ohameiri/maya/hardware/lr2021-esp32s3/docs/enclosure/01_closed_front_left.png

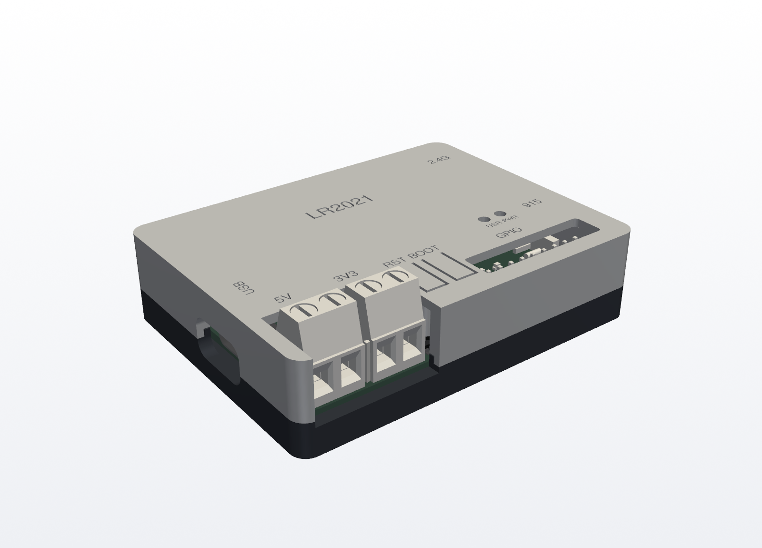
hardware/lr2021-esp32s3/docs/enclosure/01_closed_front_left.png
