ohameiri/maya/hardware/lr2021-esp32s3/docs/enclosure/03_exploded.png

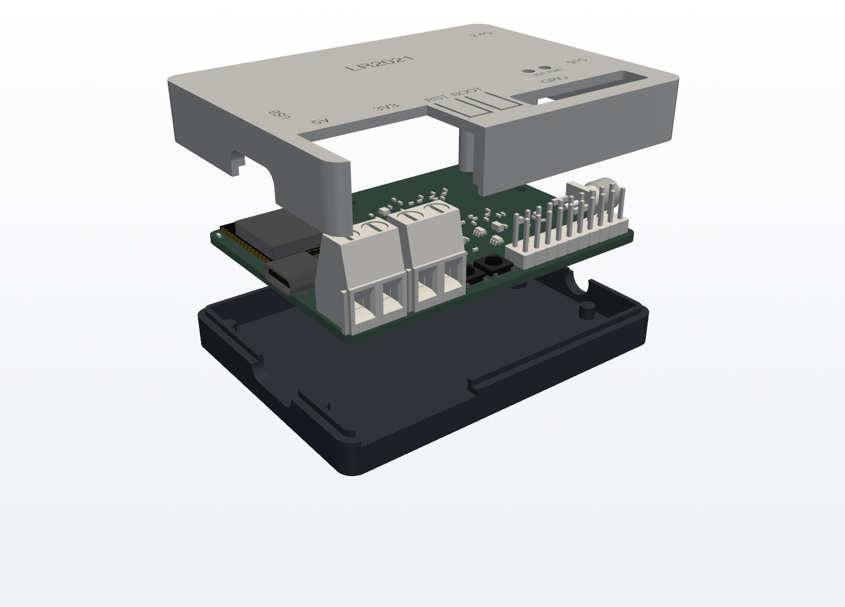
hardware/lr2021-esp32s3/docs/enclosure/03_exploded.png
