ohameiri/maya/hardware/lr2021-esp32s3/docs/enclosure/04_base_with_board.png

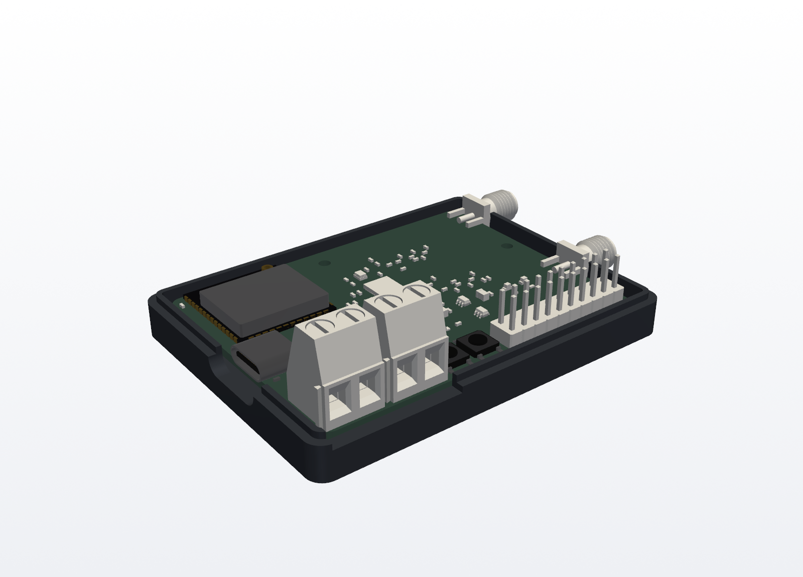
hardware/lr2021-esp32s3/docs/enclosure/04_base_with_board.png
