ohameiri/maya/hardware/lr2021-esp32s3/docs/enclosure/06_lid_top.png

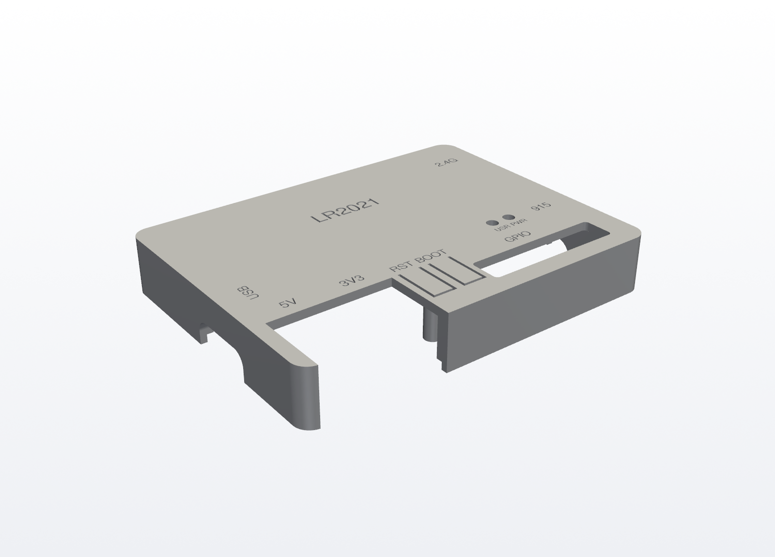
hardware/lr2021-esp32s3/docs/enclosure/06_lid_top.png
