ohameiri/maya/hardware/lr2021-esp32s3/docs/enclosure/07_lid_underside.png

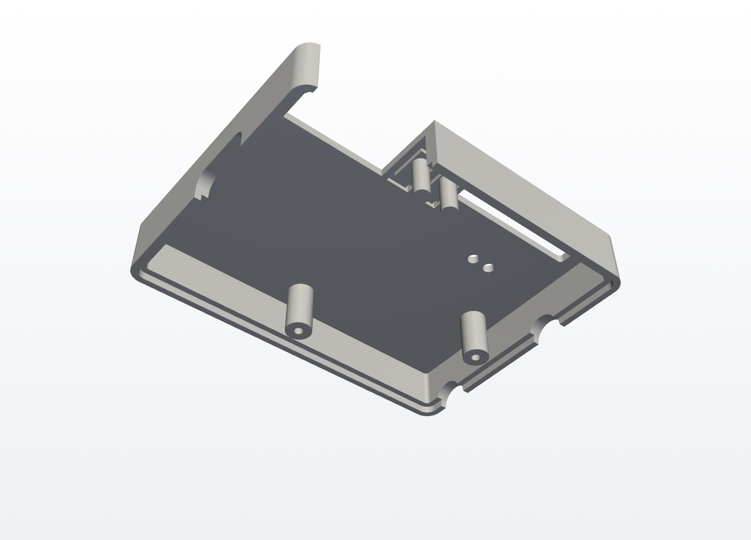
hardware/lr2021-esp32s3/docs/enclosure/07_lid_underside.png
