ohameiri/maya/hardware/lr2021-esp32s3/docs/enclosure/09_exploded_no_board.png

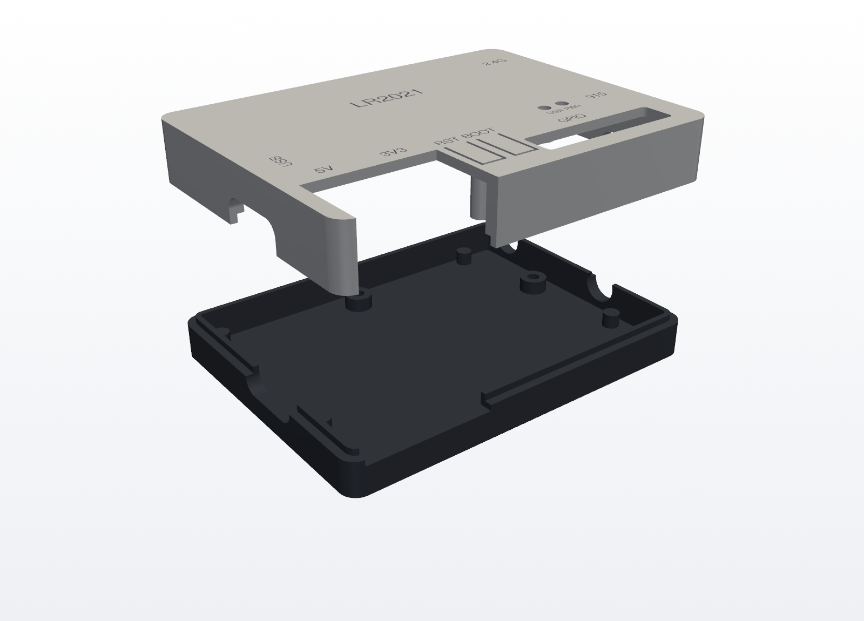
hardware/lr2021-esp32s3/docs/enclosure/09_exploded_no_board.png
