ohameiri/maya/hardware/lr2021-esp32s3/docs/enclosure/10_top_view.png

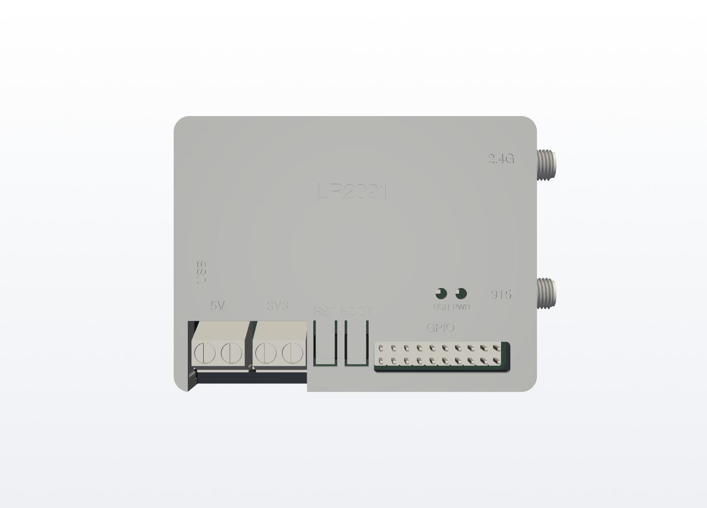
hardware/lr2021-esp32s3/docs/enclosure/10_top_view.png
