ohameiri/maya/hardware/lr2021-esp32s3/docs/enclosure/11_usb_side.png

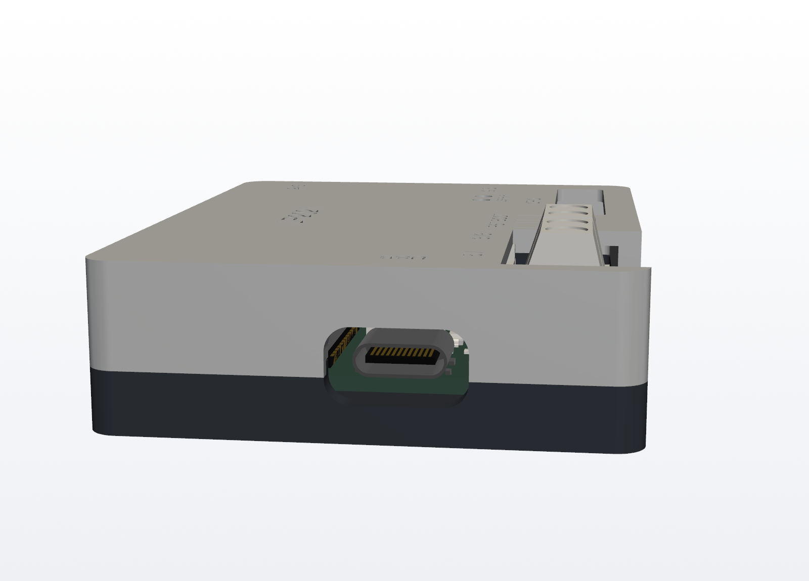
hardware/lr2021-esp32s3/docs/enclosure/11_usb_side.png
