ohameiri/maya/hardware/lr2021-esp32s3/docs/enclosure/12_sma_side.png

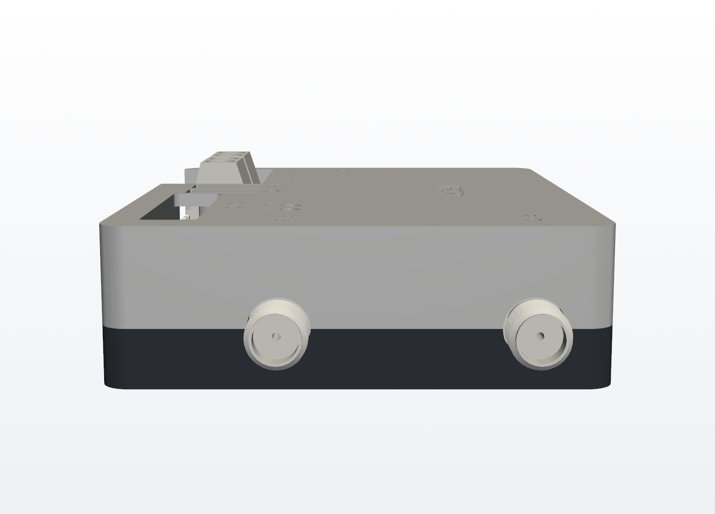
hardware/lr2021-esp32s3/docs/enclosure/12_sma_side.png
