ohameiri/maya/hardware/lr2021-esp32s3/docs/gallery/3d_esp32_zoom_angle.png

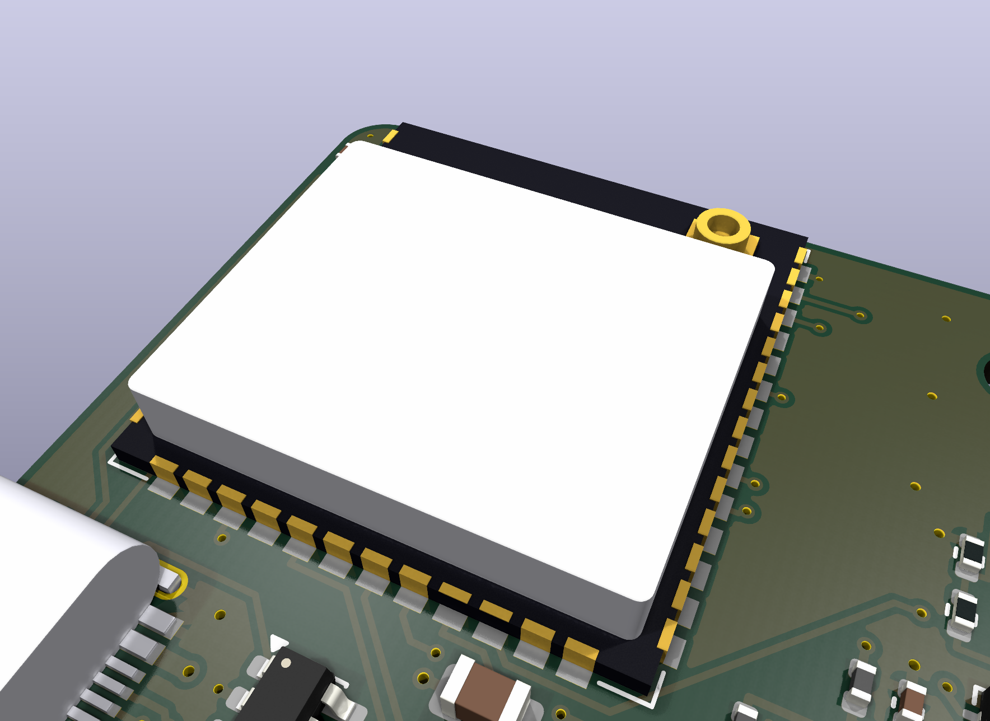
hardware/lr2021-esp32s3/docs/gallery/3d_esp32_zoom_angle.png
