ohameiri/maya/hardware/lr2021-esp32s3/docs/gallery/3d_iso_front_left.png

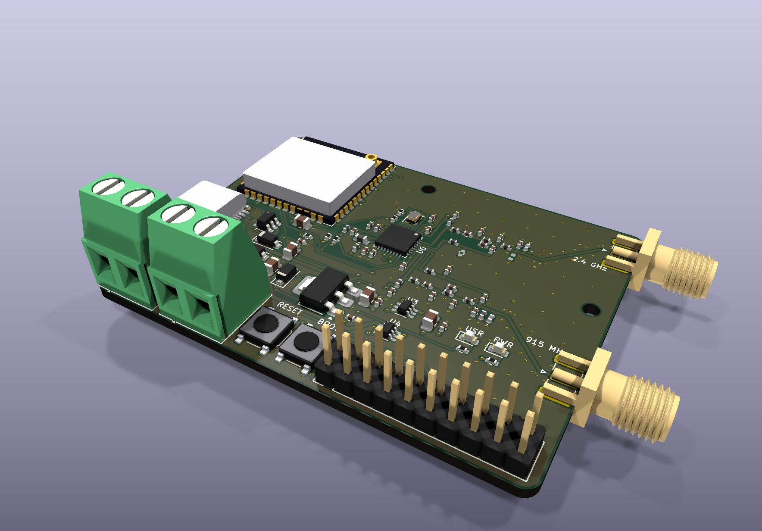
hardware/lr2021-esp32s3/docs/gallery/3d_iso_front_left.png
