ohameiri/maya/hardware/lr2021-esp32s3/docs/gallery/3d_power_usb_closeup.png

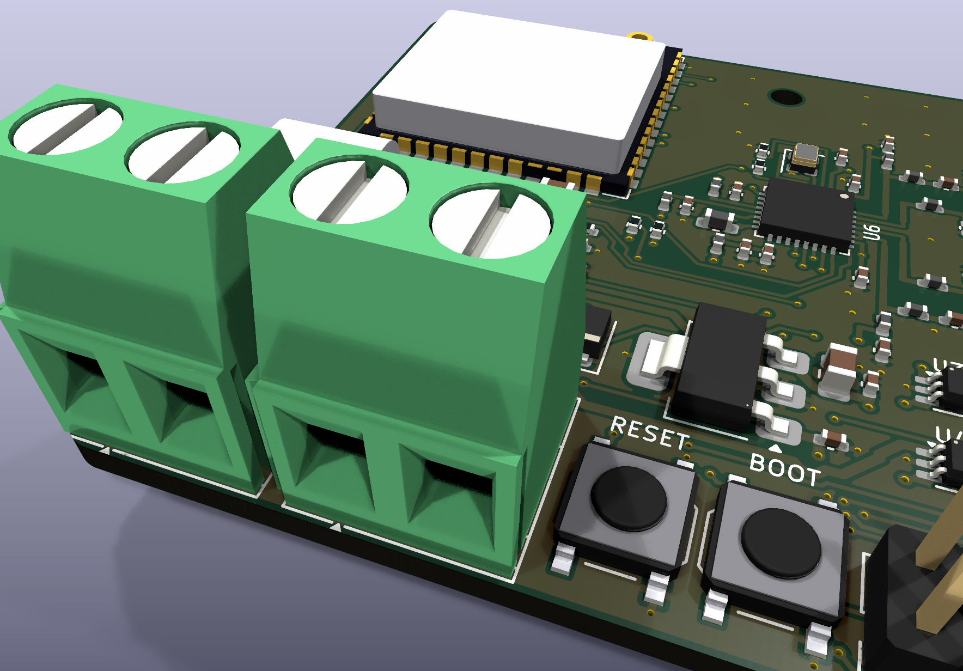
hardware/lr2021-esp32s3/docs/gallery/3d_power_usb_closeup.png
