ohameiri/maya/hardware/lr2021-esp32s3/docs/gallery/pcb_2d_bottom.png

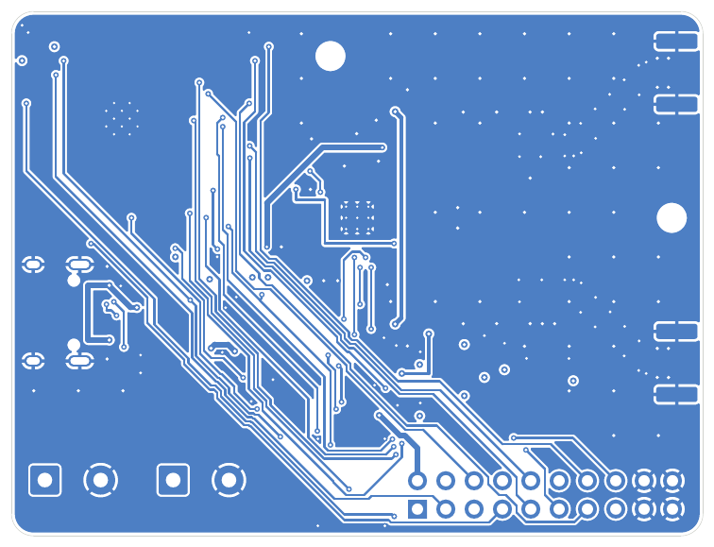
hardware/lr2021-esp32s3/docs/gallery/pcb_2d_bottom.png
