ohameiri/maya/hardware/lr2021-esp32s3/docs/gallery/sch_lr2021.png

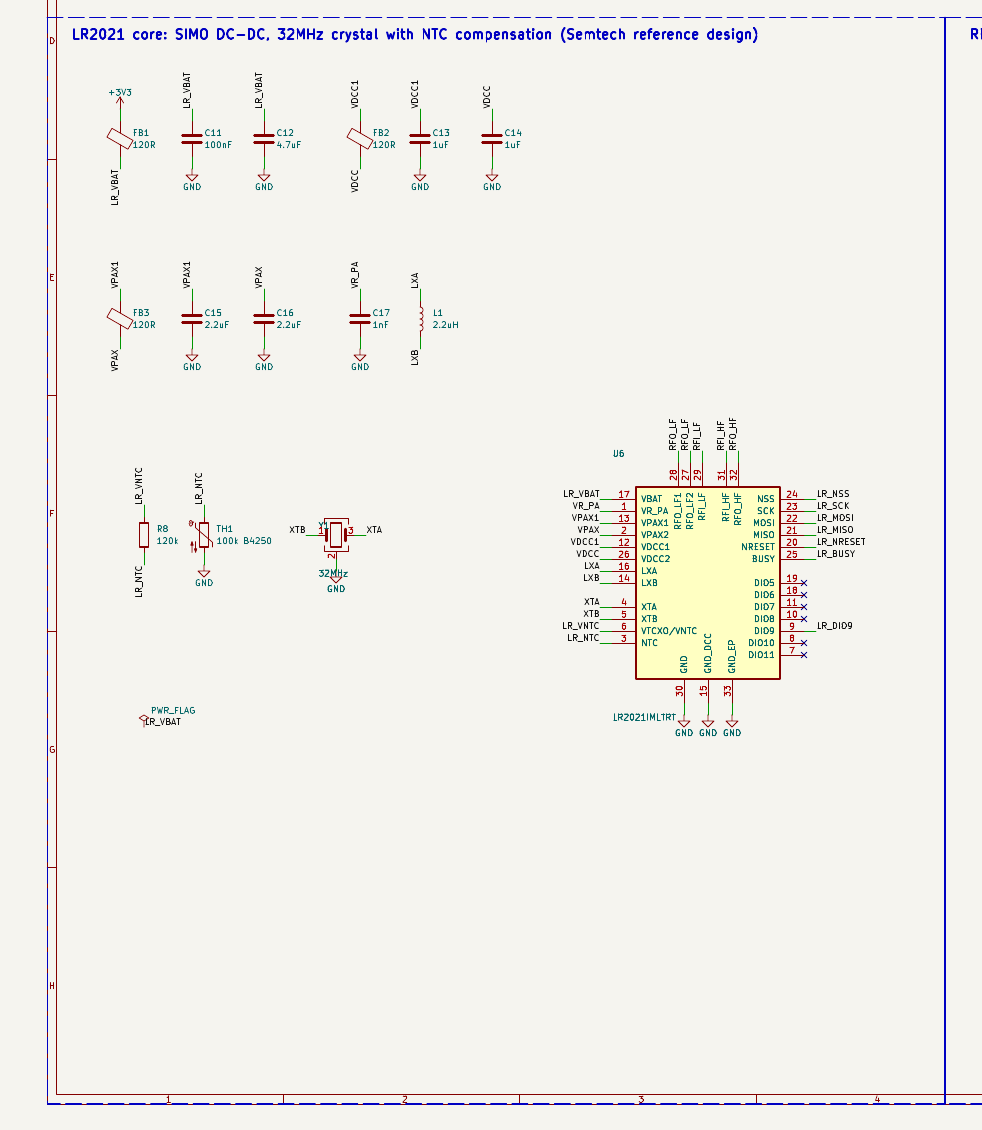
hardware/lr2021-esp32s3/docs/gallery/sch_lr2021.png
