ohameiri/maya/hardware/lr2021-esp32s3/docs/gallery/sch_power.png

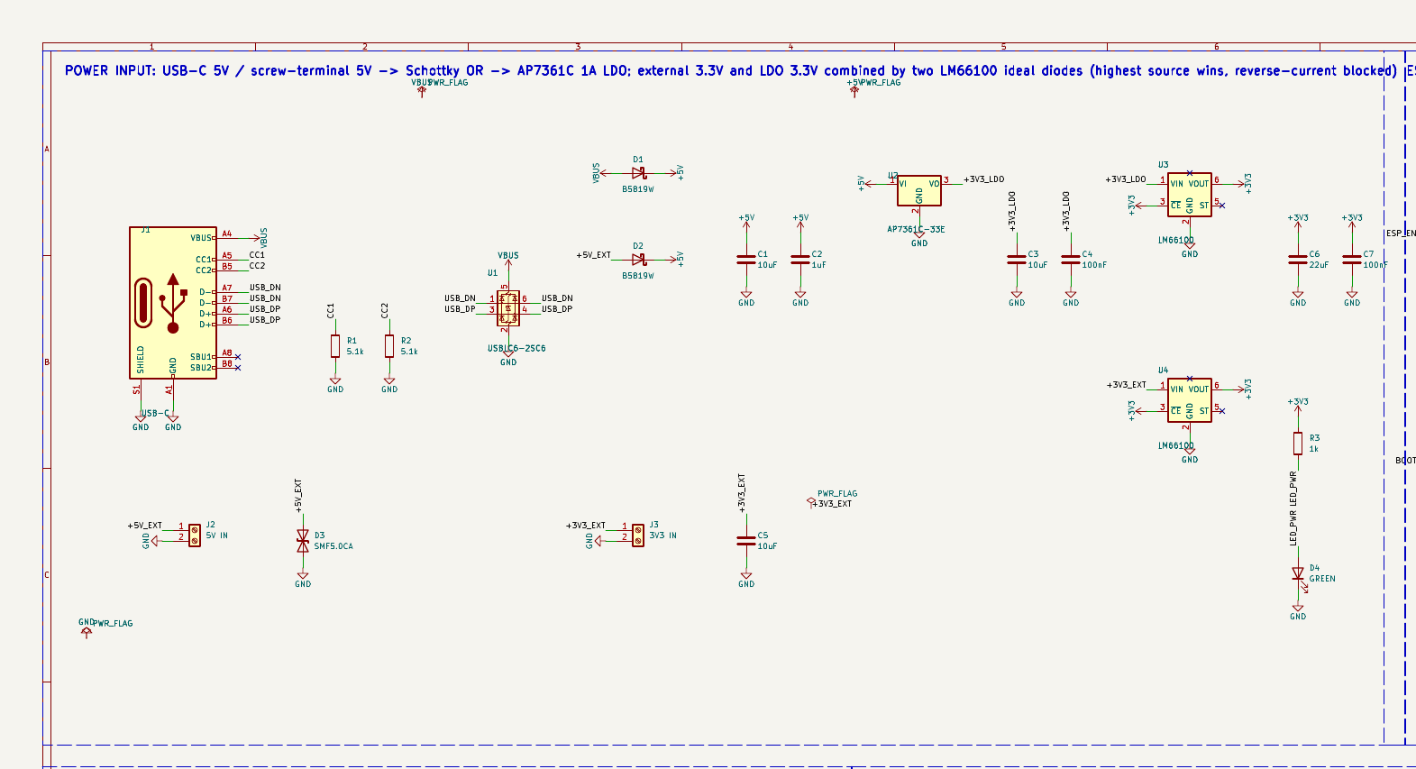
hardware/lr2021-esp32s3/docs/gallery/sch_power.png
