ohameiri/maya/hardware/lr2021-esp32s3/docs/gerber_copper_layers.png

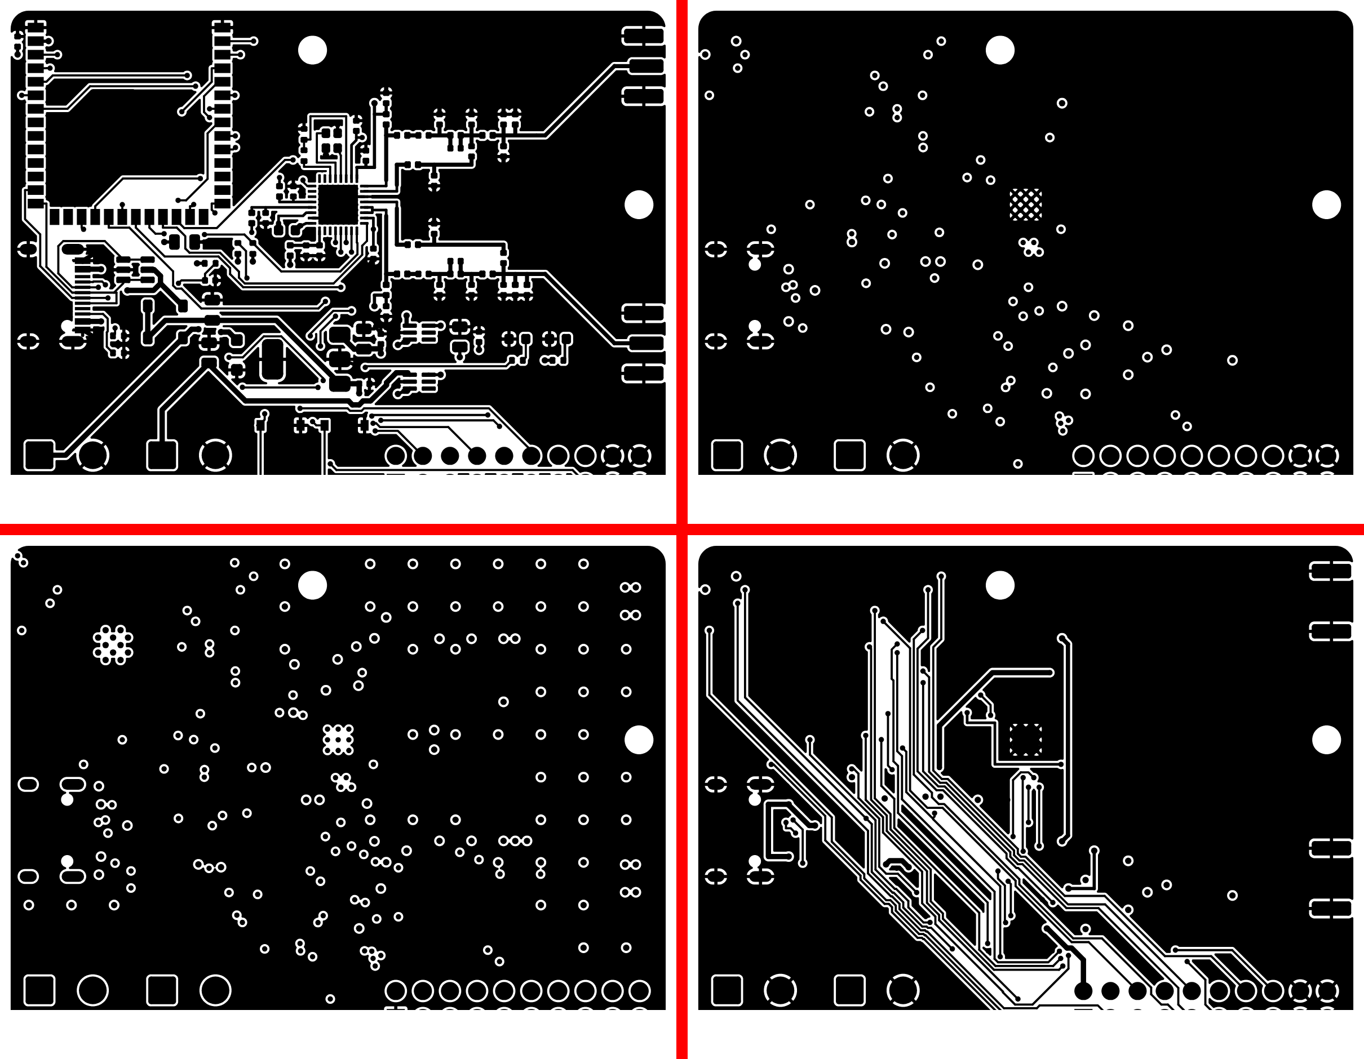
hardware/lr2021-esp32s3/docs/gerber_copper_layers.png
