ohameiri/maya/hardware/lr2021-esp32s3/docs/pcb_3d_sma_top.png

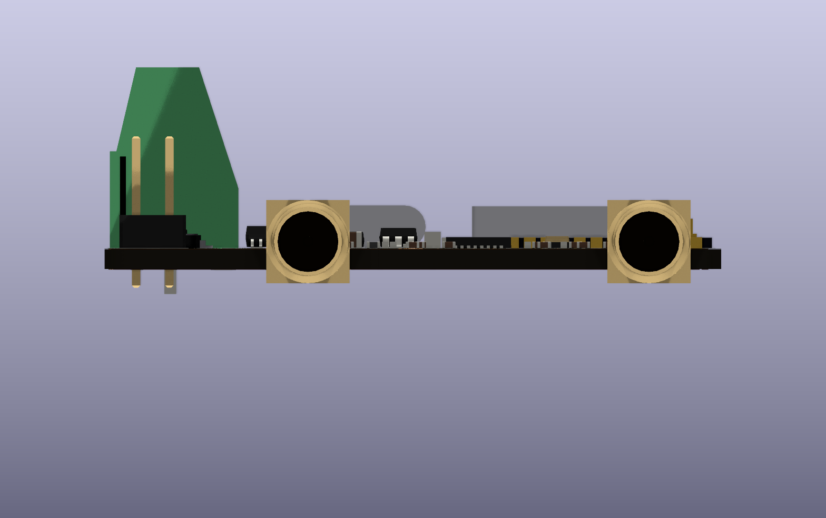
hardware/lr2021-esp32s3/docs/pcb_3d_sma_top.png
