ohameiri/maya/hardware/lr2021-esp32s3/docs/pcb_3d_terminals.png

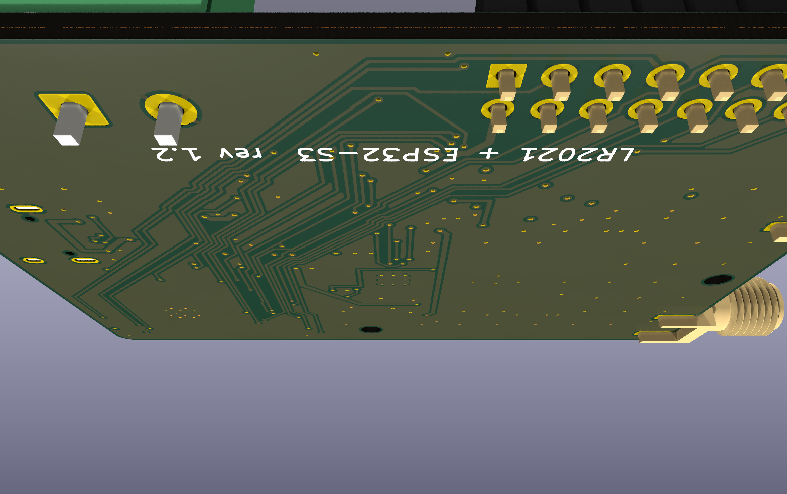
hardware/lr2021-esp32s3/docs/pcb_3d_terminals.png
