ohameiri/maya/hardware/lr2021-esp32s3/docs/pcb_inner2.png

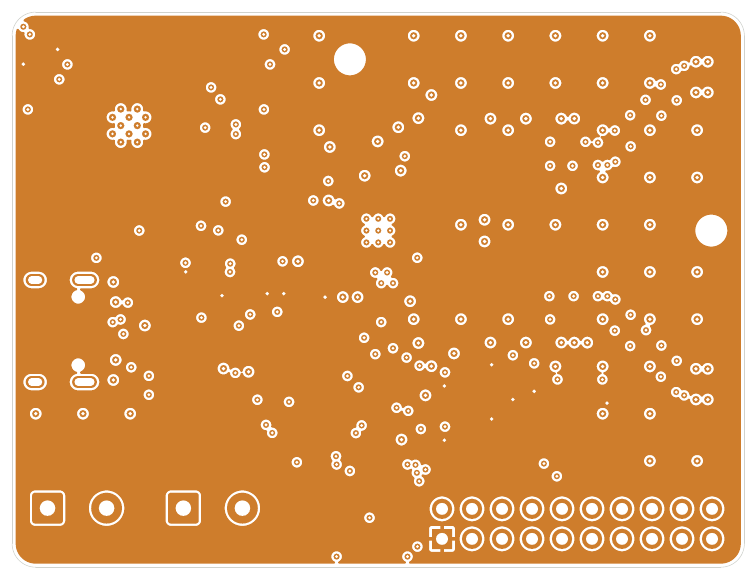
hardware/lr2021-esp32s3/docs/pcb_inner2.png
