ohameiri/maya/hardware/lr2021-esp32s3/enclosure/enclosure_assembly.step

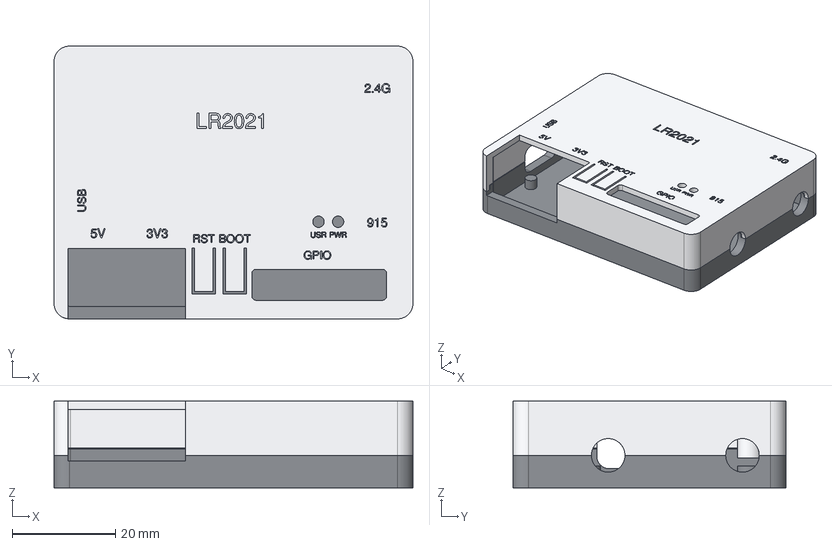
[picture p37: CAD file, 2026-10-03]
hardware/lr2021-esp32s3/enclosure/enclosure_assembly.step
69.5 x 52.8 x 16.8 mm
base
lid
