ohameiri/maya/hardware/lr2021-esp32s3/enclosure/enclosure_lid.step

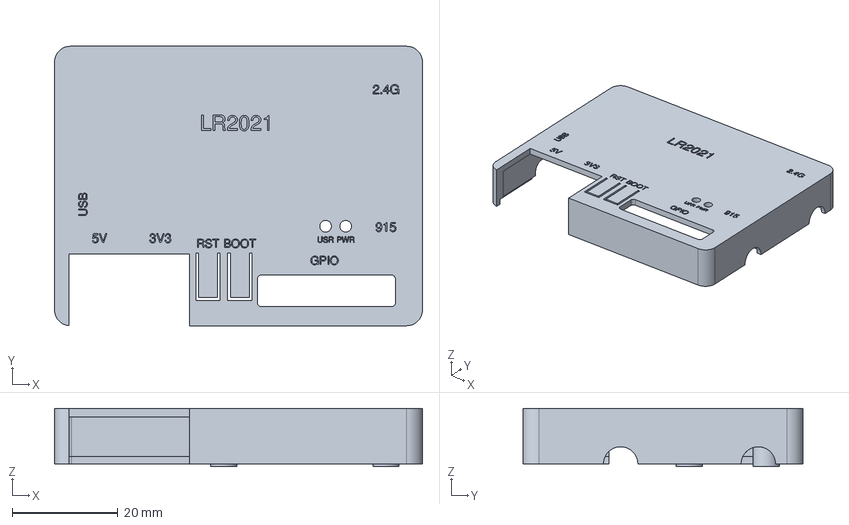
[picture p38: CAD file, 2026-10-03]
hardware/lr2021-esp32s3/enclosure/enclosure_lid.step
69.5 x 52.8 x 11.0 mm
