ohameiri/maya/hardware/lr2021-esp32s3/enclosure/enclosure_base.step

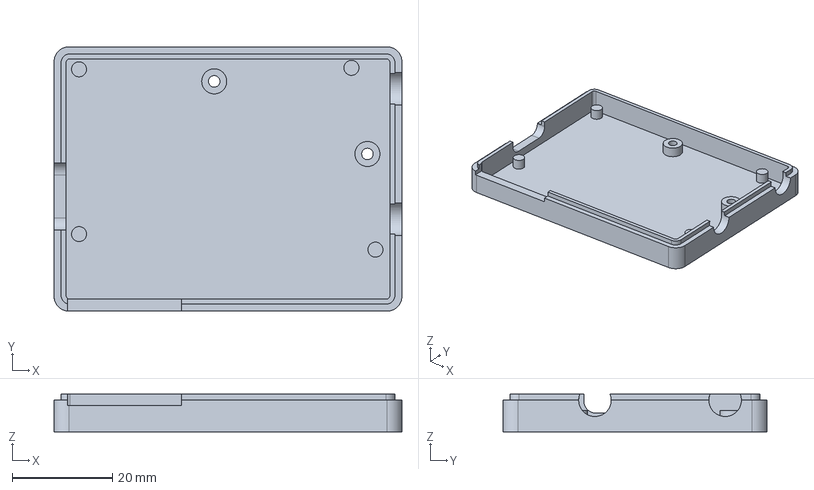
[picture p39: CAD file, 2026-10-03]
hardware/lr2021-esp32s3/enclosure/enclosure_base.step
69.5 x 52.8 x 7.50 mm
