ohameiri/maya/(list of files, cad)

Other CAD files:
hardware/lr2021-esp32s3/enclosure/enclosure_base.stl
hardware/lr2021-esp32s3/enclosure/enclosure_lid.stl
