ohameiri/maya/hardware/lr2021-esp32s3/docs/lr2021_esp32s3_pcb_layers.pdf

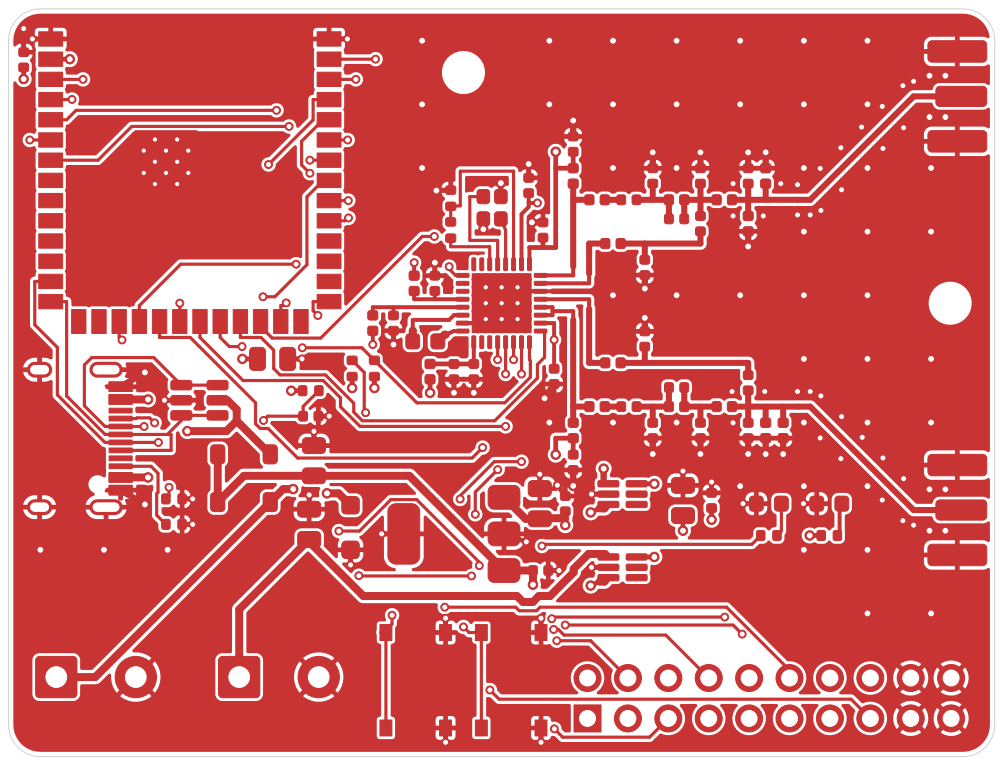
[picture p40: page 1]

Id: 1/6 Title: File: lr2021_esp32s3.kicad_pcb Sheet:

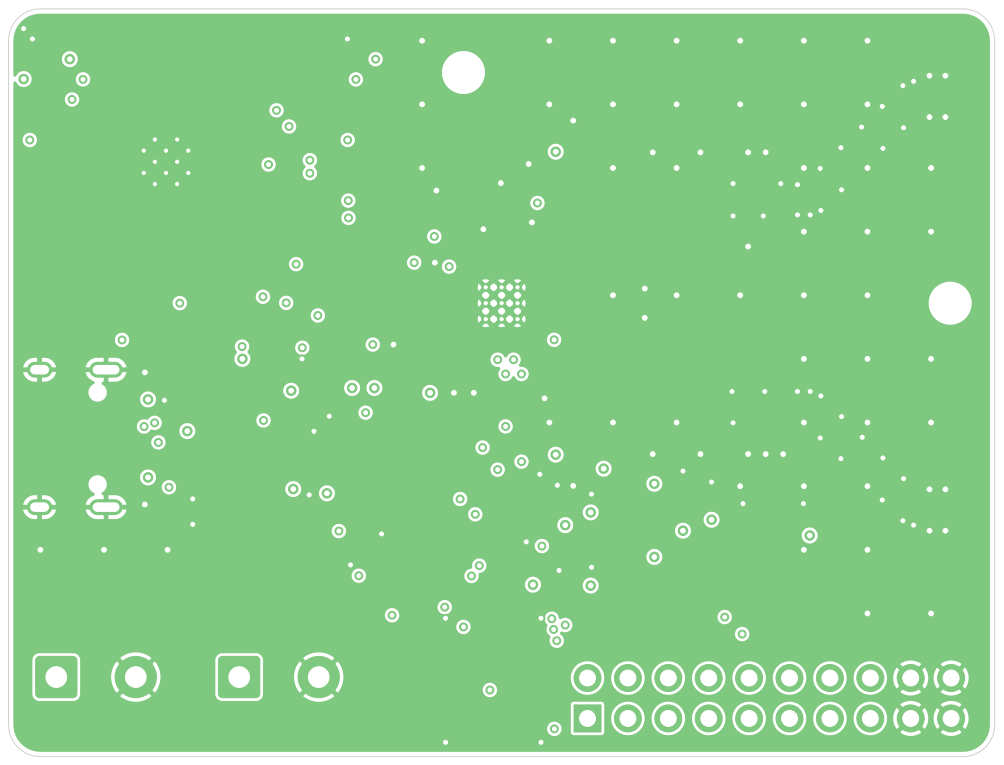
[picture p41: page 2]

Id: 2/6 Title: File: lr2021_esp32s3.kicad_pcb Sheet:

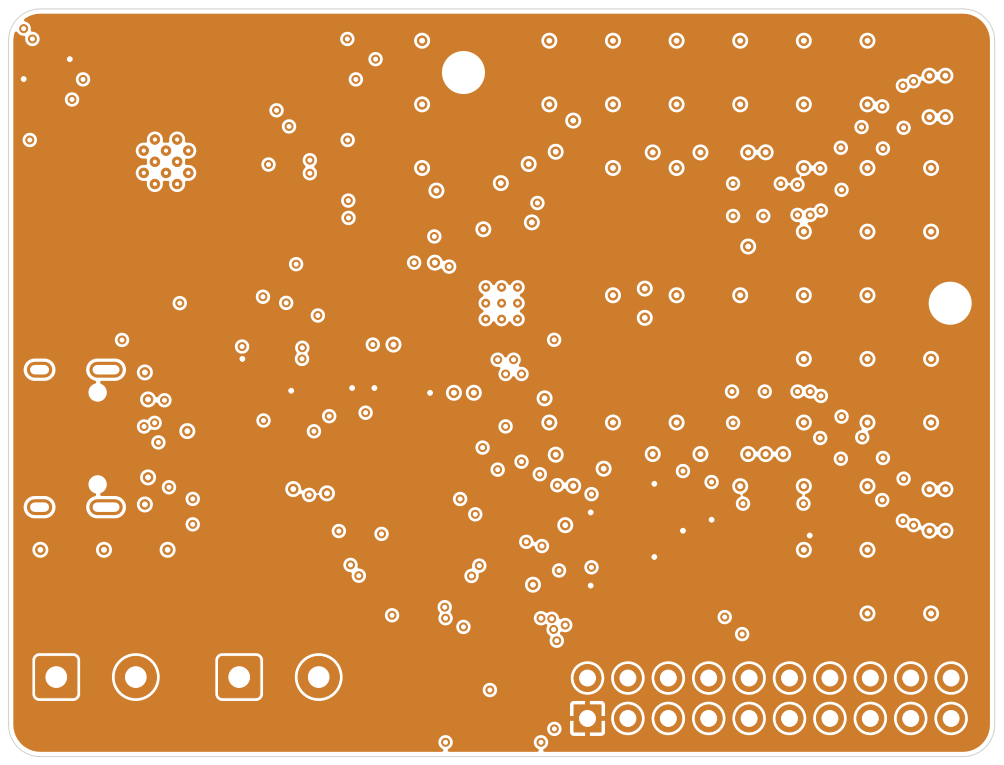
[picture p42: page 3]

Id: 3/6 Title: File: lr2021_esp32s3.kicad_pcb Sheet:

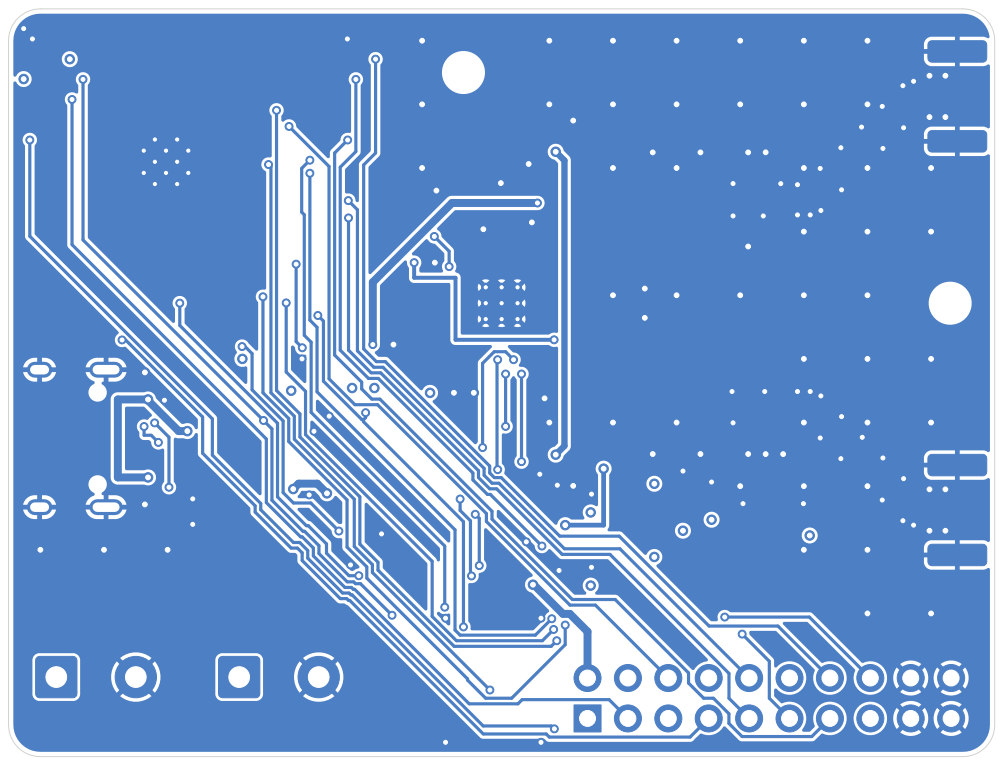
[picture p43: page 4]

Id: 4/6 Title: File: lr2021_esp32s3.kicad_pcb Sheet:

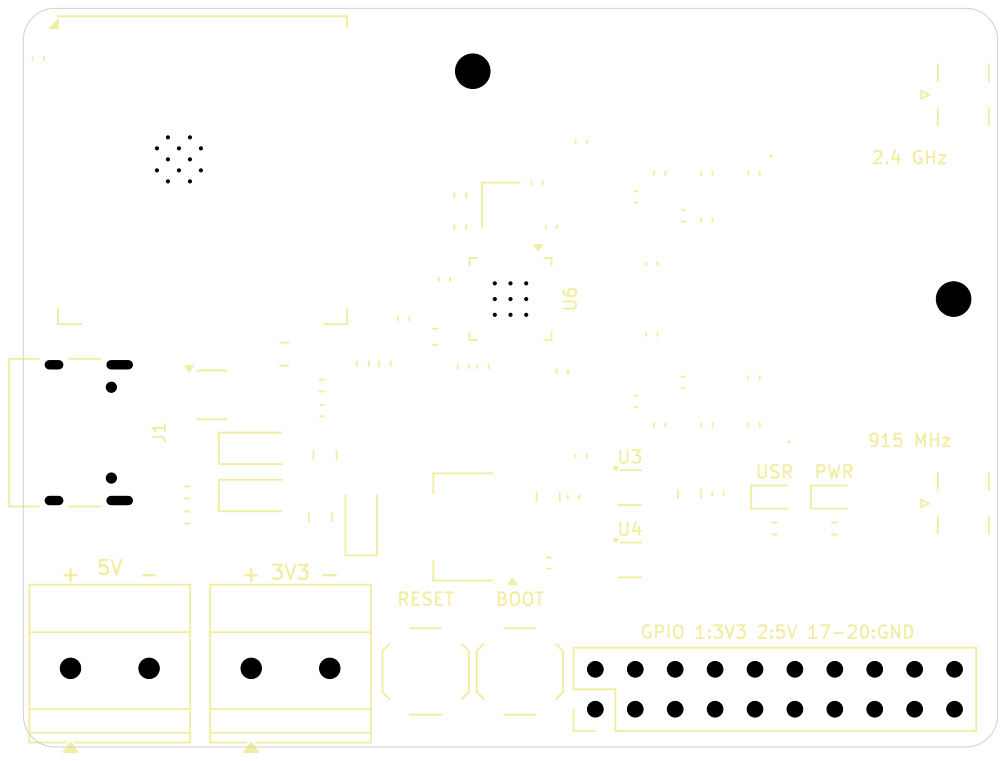
[picture p44: page 5]

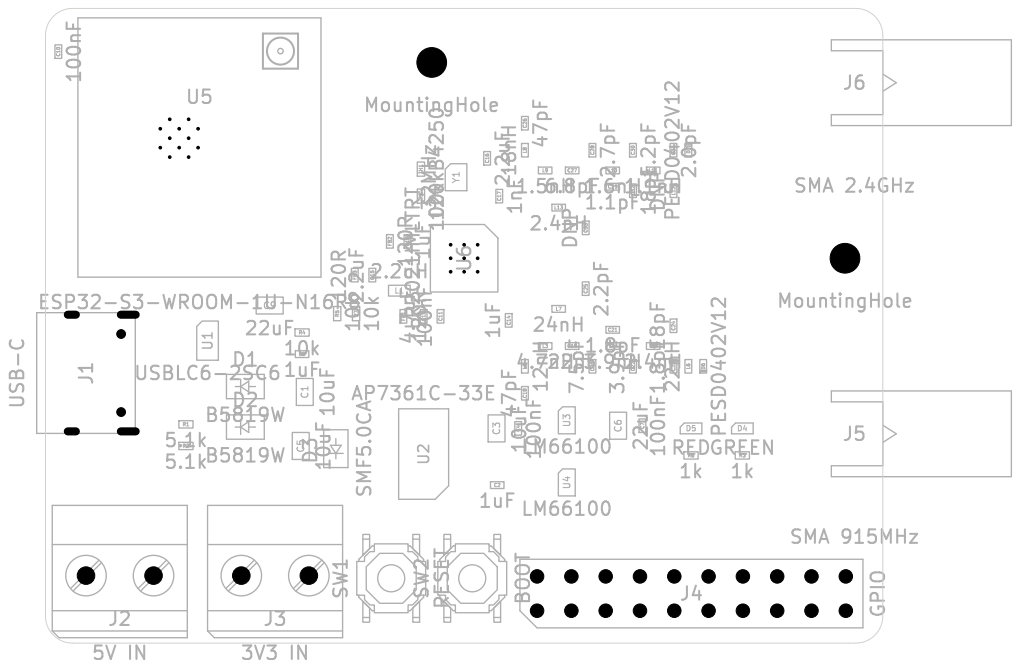
[picture p45: page 6]
