ohameiri/maya/hardware/lr2021-esp32s3/docs/lr2021_esp32s3_schematic.pdf

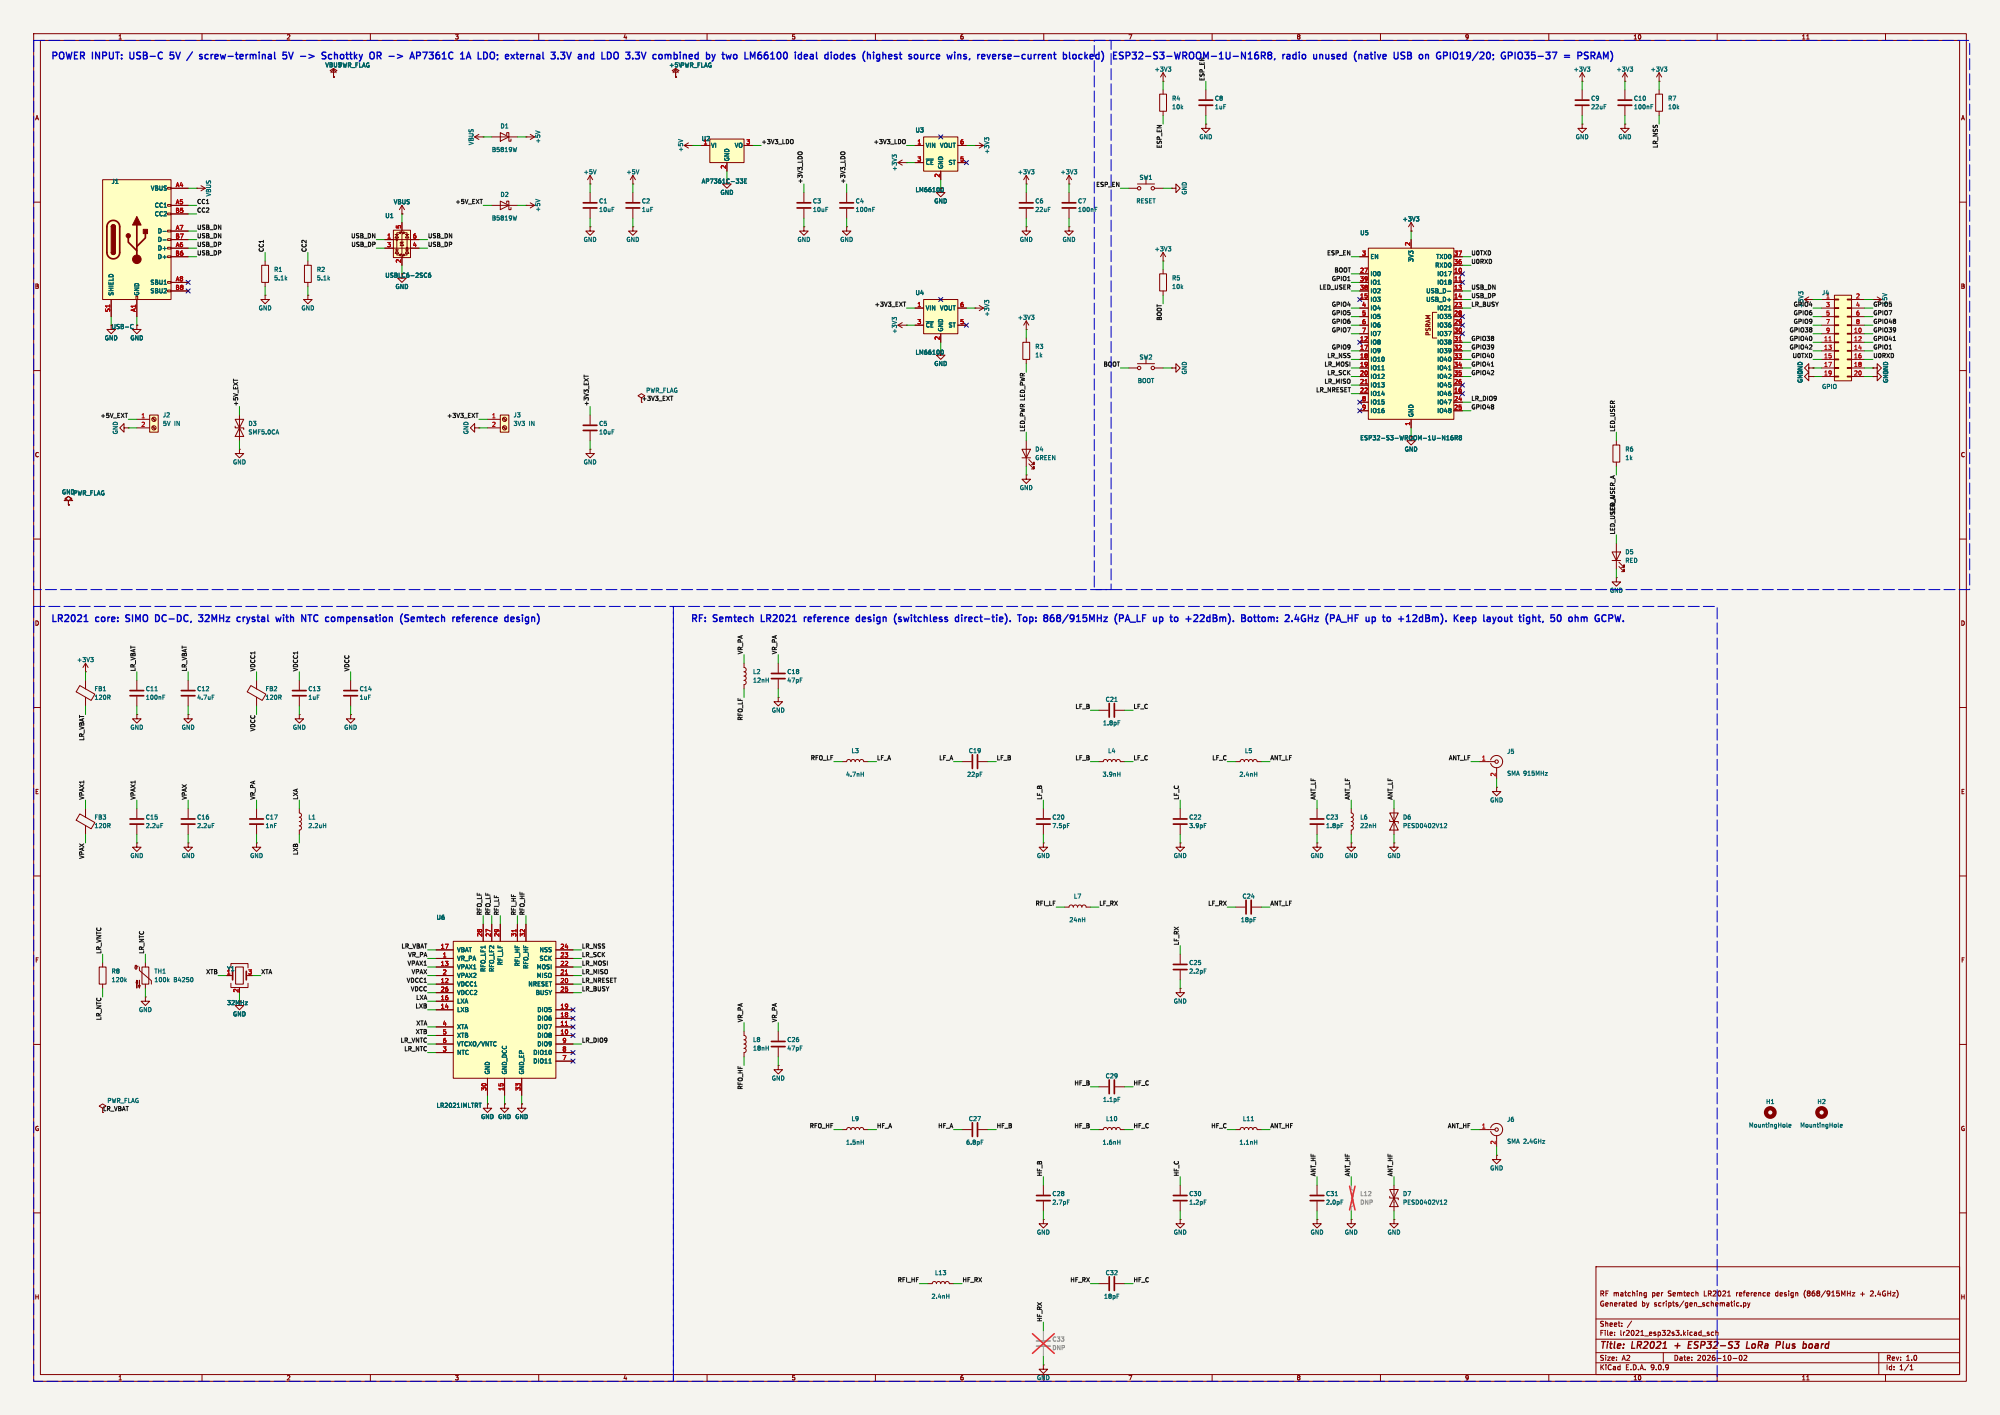
[picture p46: page 1]
