ohameiri/maya/hardware/lr2021-esp32s3/lr2021_esp32s3.kicad_pcb

## KiCad design hardware/lr2021-esp32s3/lr2021_esp32s3.kicad_pcb (2026-10-04)

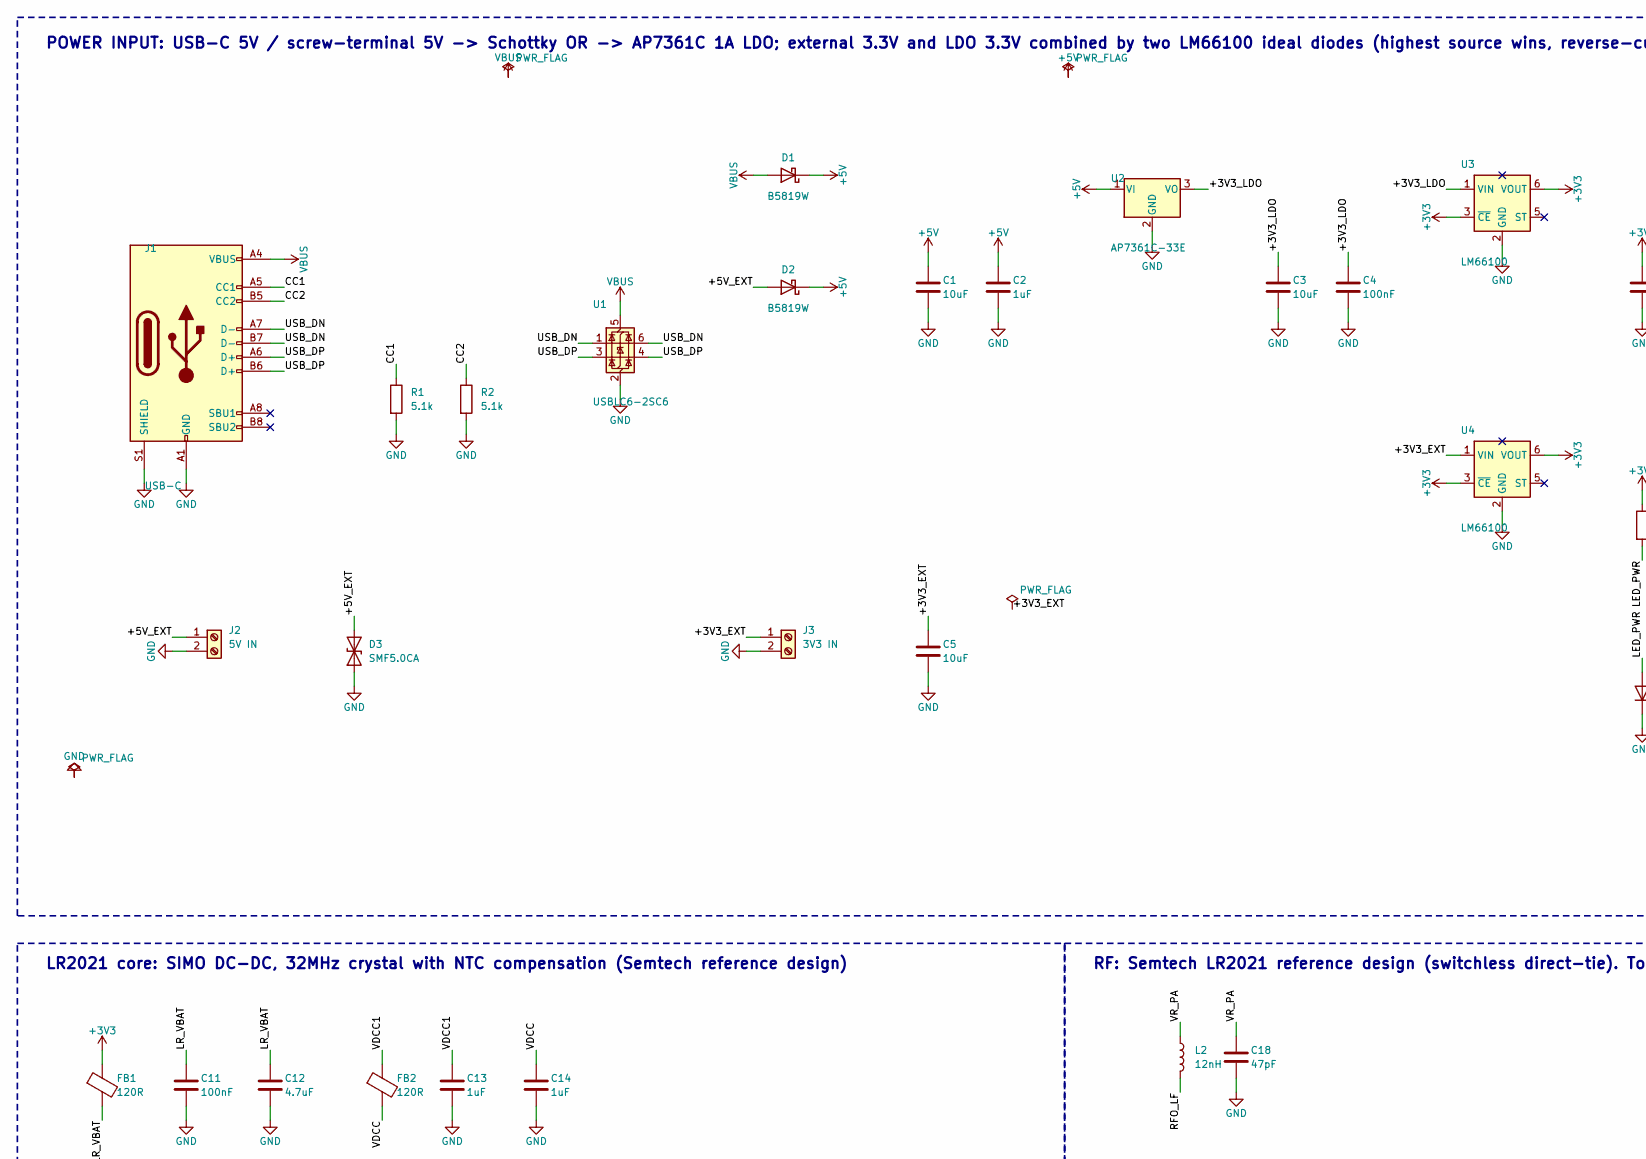
[picture p47: schematic lr2021_esp32s3.kicad_sch, LR2021 + ESP32-S3 LoRa Plus board, part in row 1, column 1]

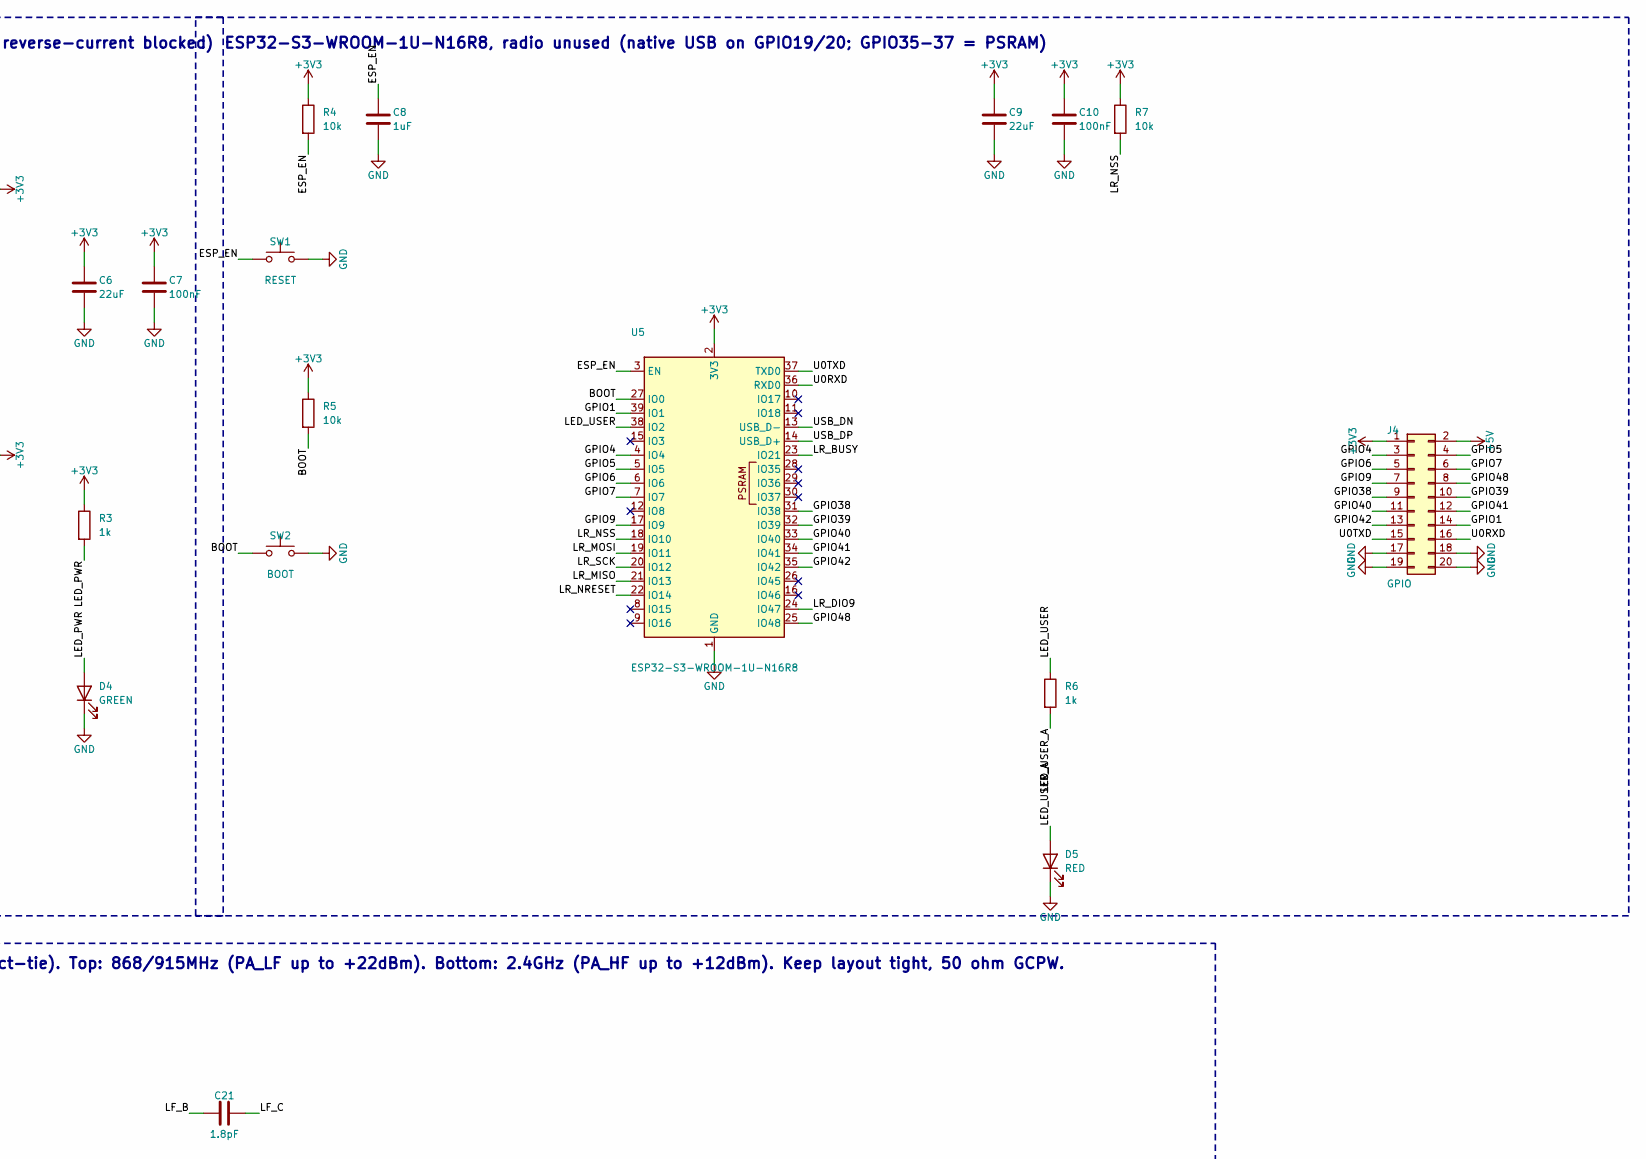
[picture p48: schematic lr2021_esp32s3.kicad_sch, LR2021 + ESP32-S3 LoRa Plus board, part in row 1, column 2]

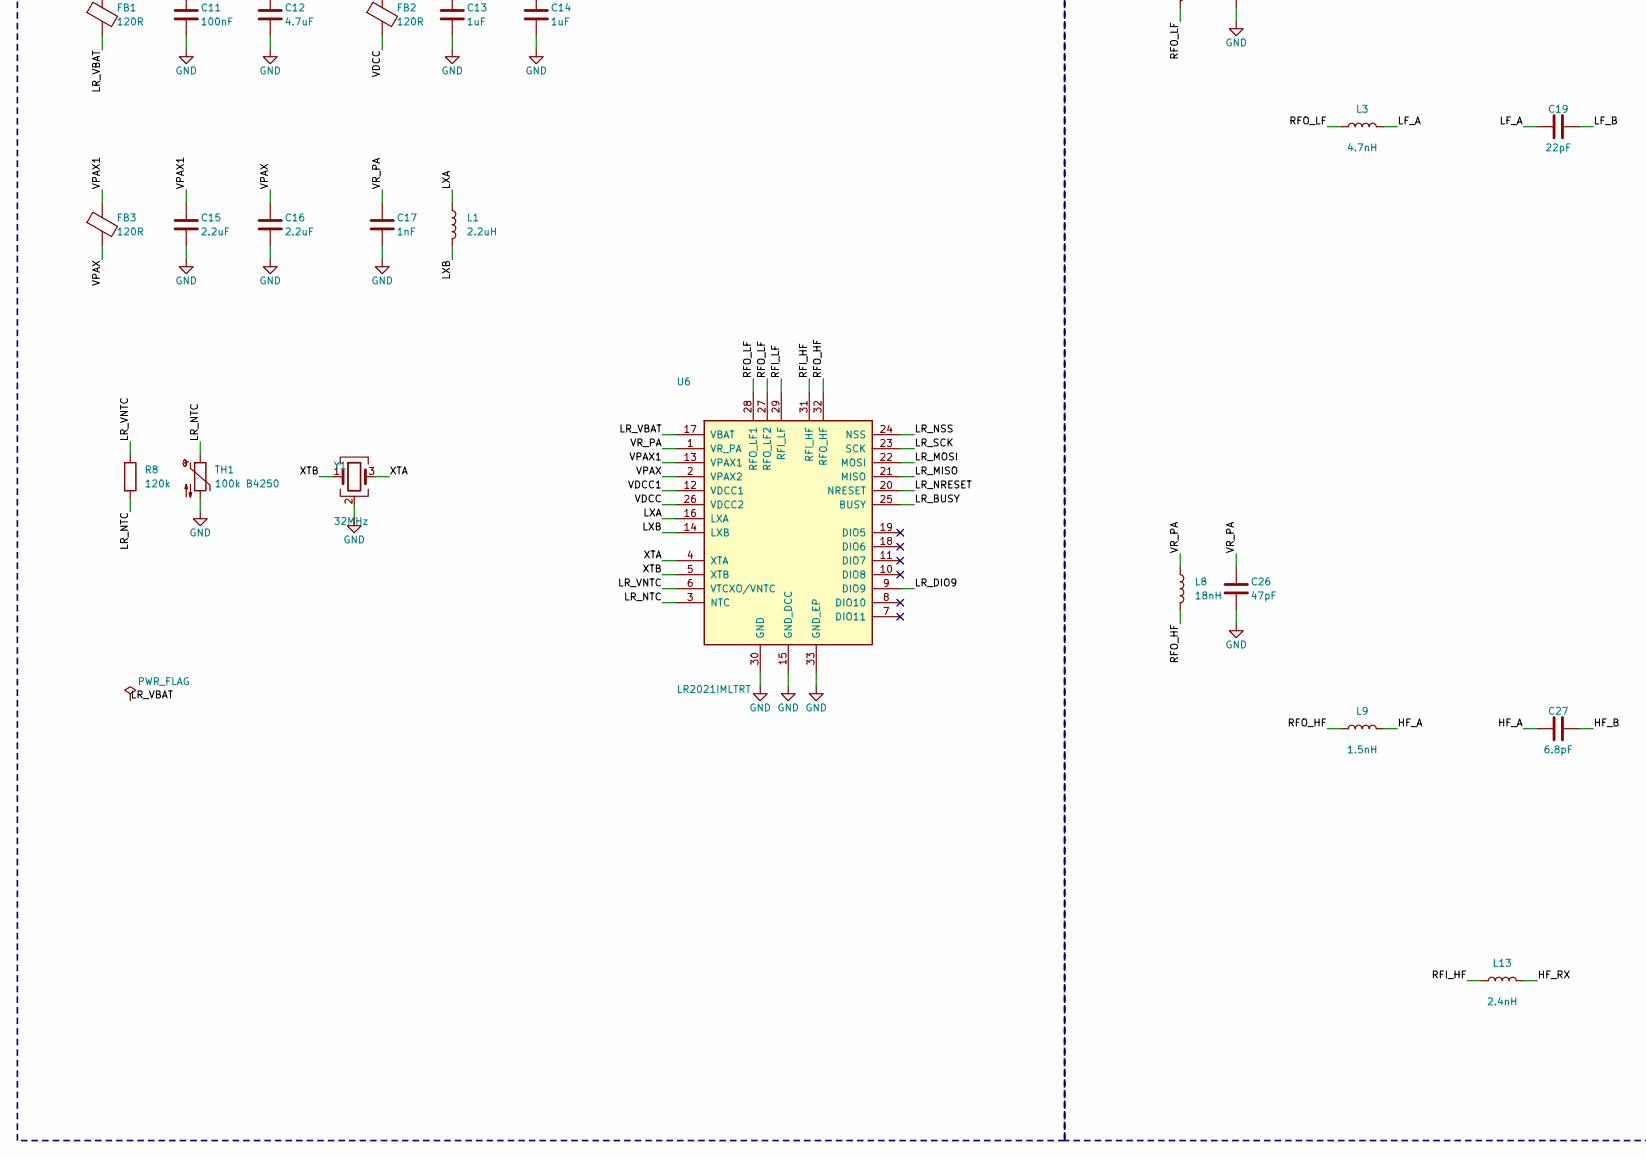
[picture p49: schematic lr2021_esp32s3.kicad_sch, LR2021 + ESP32-S3 LoRa Plus board, part in row 2, column 1]

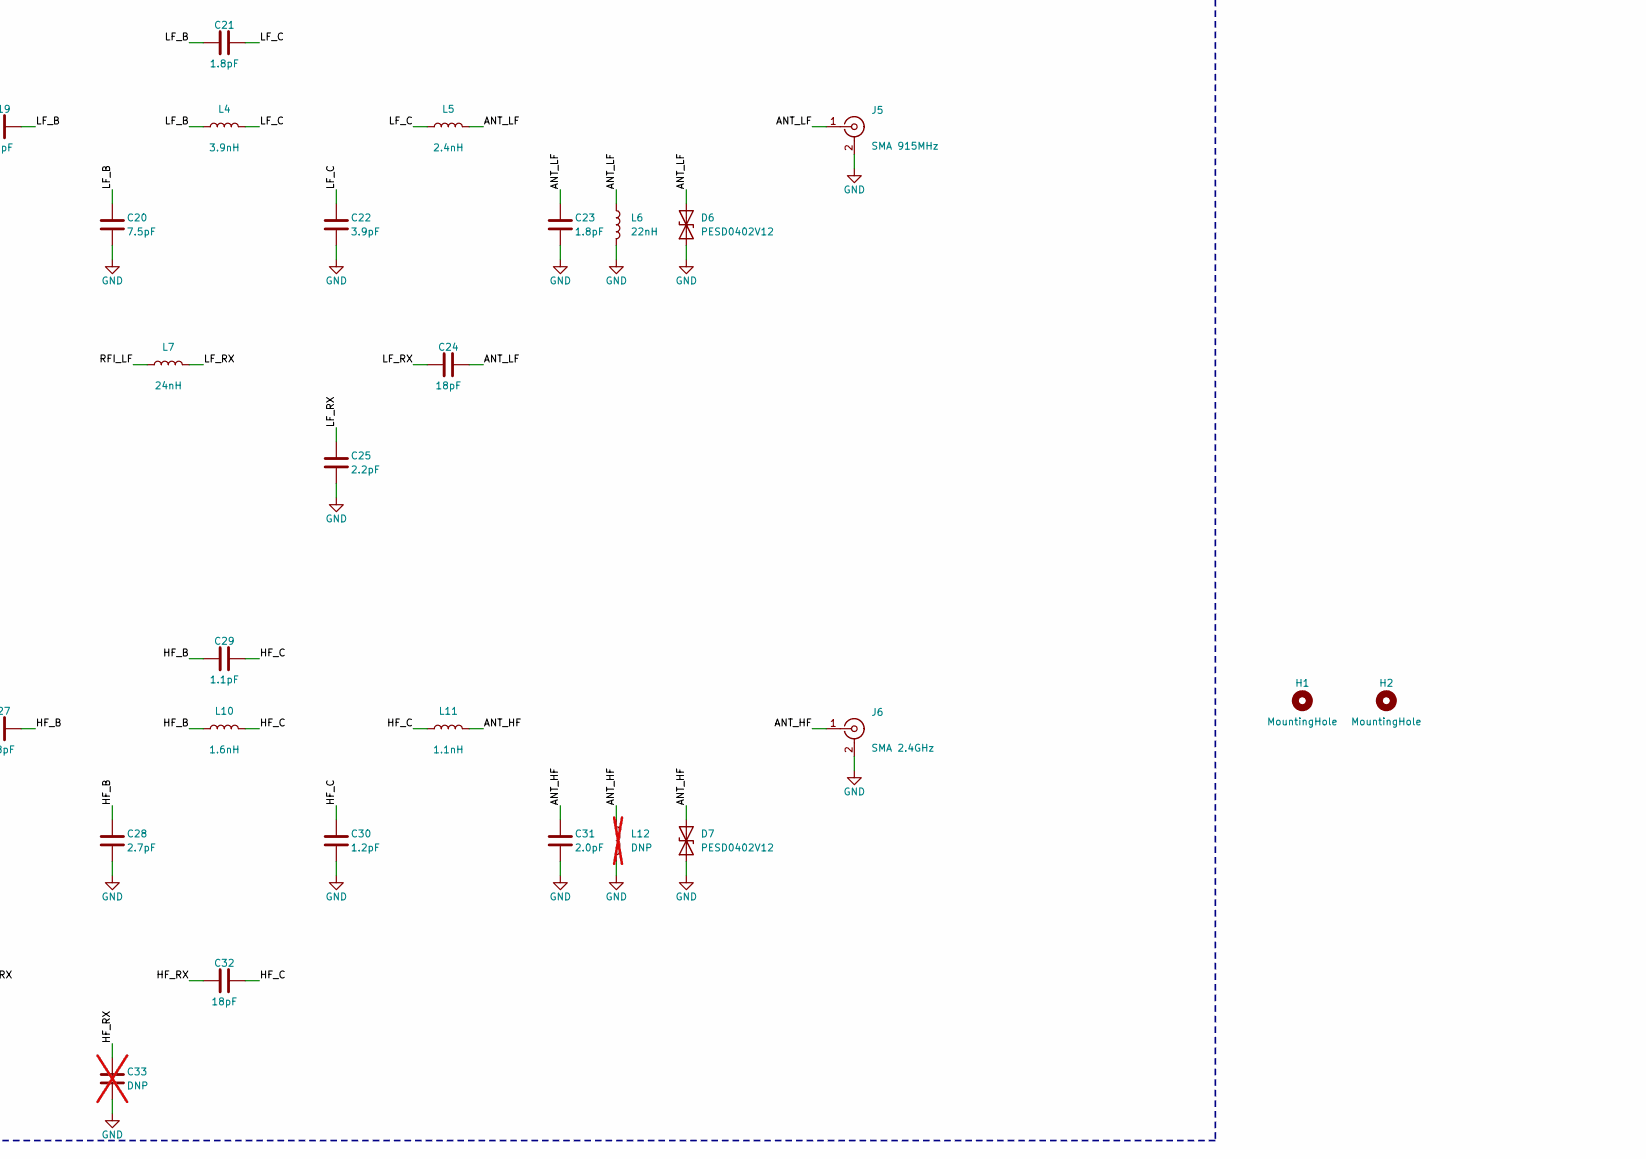
[picture p50: schematic lr2021_esp32s3.kicad_sch, LR2021 + ESP32-S3 LoRa Plus board, part in row 2, column 2]

Parts:
C1, C3, C5: 10uF; C_0805_2012Metric; MPN CL21A106KAYNNNE; LCSC C15850
C2, C8, C13, C14: 1uF; C_0402_1005Metric; MPN CL05A105KA5NQNC; LCSC C52923
C4, C7, C10, C11: 100nF; C_0402_1005Metric; MPN CL05B104KO5NNNC; LCSC C1525
C6, C9: 22uF; C_0805_2012Metric; MPN CL21A226MAQNNNE; LCSC C45783
C12: 4.7uF; C_0402_1005Metric; MPN CL05A475MP5NRNC; LCSC C23733
C15, C16: 2.2uF; C_0402_1005Metric; MPN CL05A225KP5NSNC; LCSC C107369
C17: 1nF; C_0402_1005Metric; MPN 0402B102K500NT; LCSC C1523
C18, C26: 47pF; C_0402_1005Metric; MPN CC0402JRNPO9BN470; LCSC C60137
C19: 22pF; C_0402_1005Metric; MPN 0402CG220J500NT; LCSC C1555
C20: 7.5pF; C_0402_1005Metric; MPN CQ0402BRNPO9BN7R5; LCSC C1855318
C21, C23: 1.8pF; C_0402_1005Metric; MPN CC0402BRNPO9BN1R8; LCSC C327209
C22: 3.9pF; C_0402_1005Metric; MPN CC0402BRNPO9BN3R9; LCSC C505474
C24, C32: 18pF; C_0402_1005Metric; MPN 0402CG180J500NT; LCSC C1549
C25: 2.2pF; C_0402_1005Metric; MPN CC0402BRNPO9BN2R2; LCSC C325452
C27: 6.8pF; C_0402_1005Metric; MPN CC0402BRNPO9BN6R8; LCSC C327291
C28: 2.7pF; C_0402_1005Metric; MPN CC0402BRNPO9BN2R7; LCSC C326937
C29: 1.1pF; C_0402_1005Metric; MPN RF15N1R1B500CT; LCSC C180259
C30: 1.2pF; C_0402_1005Metric; MPN CC0402BRNPO9BN1R2; LCSC C327292
C31: 2.0pF; C_0402_1005Metric; MPN CC0402BRNPO9BN2R0; LCSC C281756
C33: DNP; C_0402_1005Metric; not fitted
D1, D2: B5819W; D_SOD-123; MPN B5819W; LCSC C8598
D3: SMF5.0CA; D_SOD-123F; MPN SMF5.0CA; LCSC C2980402
D4: GREEN; LED_0603_1608Metric; MPN LTST-C190KGKT; LCSC C125094
D5: RED; LED_0603_1608Metric; MPN KT-0603R; LCSC C2286
D6, D7: PESD0402V12; D_0402_1005Metric; MPN PESD0402V12; LCSC C19626255
FB1, FB2, FB3: 120R; L_0402_1005Metric; MPN BLM15AG121SN1D; LCSC C85812
H1, H2: MountingHole; MountingHole_2.2mm_M2
J1: USB-C; USB_C_Receptacle_HRO_TYPE-C-31-M-12; MPN HRO TYPE-C-31-M-12; LCSC C165948
J2: 5V IN; TerminalBlock_Phoenix_MKDS-1,5-2_1x02_P5.00mm_Horizontal; MPN KF301-5.0-2P; LCSC C474881
J3: 3V3 IN; TerminalBlock_Phoenix_MKDS-1,5-2_1x02_P5.00mm_Horizontal; MPN KF301-5.0-2P; LCSC C474881
J4: GPIO; PinHeader_2x10_P2.54mm_Vertical; MPN HX PZ2.54-2x10P ZZ; LCSC C42372518
J5: SMA 915MHz; SMA_Samtec_SMA-J-P-H-ST-EM1_EdgeMount; MPN SMA-J-P-H-ST-EM1; LCSC C5199907
J6: SMA 2.4GHz; SMA_Samtec_SMA-J-P-H-ST-EM1_EdgeMount; MPN SMA-J-P-H-ST-EM1; LCSC C5199907
L1: 2.2uH; L_0603_1608Metric; MPN LQM18PN2R2MFRL; LCSC C337910
L2: 12nH; L_0402_1005Metric; MPN LQW15AN12NG00D; LCSC C86128
L3: 4.7nH; L_0402_1005Metric; MPN LQW15AN4N7B00D; LCSC C98064
L4: 3.9nH; L_0402_1005Metric; MPN LQW15AN3N9B00D; LCSC C98062
L5, L13: 2.4nH; L_0402_1005Metric; MPN LQW15AN2N4B00D; LCSC C113113
L6: 22nH; L_0402_1005Metric; MPN LQW15AN22NG00D; LCSC C86129
L7: 24nH; L_0402_1005Metric; MPN LQW15AN24NG00D; LCSC C167472
L8: 18nH; L_0402_1005Metric; MPN LQW15AN18NG00D; LCSC C91622
L9: 1.5nH; L_0402_1005Metric; MPN LQW15AN1N5B00D; LCSC C18221
L10: 1.6nH; L_0402_1005Metric; MPN MWSD1005C1N6STM01; LCSC C778760
L11: 1.1nH; L_0402_1005Metric; MPN MHQ1005P1N1BT000; LCSC C1332701
L12: DNP; L_0402_1005Metric; not fitted
R1, R2: 5.1k; R_0402_1005Metric; MPN 0402WGF5101TCE; LCSC C25905
R3, R6: 1k; R_0402_1005Metric; MPN 0402WGF1001TCE; LCSC C11702
R4, R5, R7: 10k; R_0402_1005Metric; MPN 0402WGF1002TCE; LCSC C25744
R8: 120k; R_0402_1005Metric; MPN 0402WGF1203TCE; LCSC C25750
SW1: RESET; SW_Push_1P1T_XKB_TS-1187A; MPN TS-1187A-B-A-B; LCSC C318884
SW2: BOOT; SW_Push_1P1T_XKB_TS-1187A; MPN TS-1187A-B-A-B; LCSC C318884
TH1: 100k B4250; R_0402_1005Metric; MPN NCP15WF104F03RC; LCSC C77130
U1: USBLC6-2SC6; SOT-23-6; MPN USBLC6-2SC6; LCSC C7519
U2: AP7361C-33E; SOT-223-3_TabPin2; MPN AP7361C-33E-13; LCSC C500795
U3, U4: LM66100; SOT-363_SC-70-6; MPN LM66100DCKR; LCSC C2869734
U5: ESP32-S3-WROOM-1U-N16R8; ESP32-S3-WROOM-1U; MPN ESP32-S3-WROOM-1U-N16R8; LCSC C3013946
U6: LR2021IMLTRT; QFN-32-1EP_5x5mm_P0.5mm_EP3.7x3.7mm_ThermalVias; MPN LR2021IMLTRT; LCSC C49421489
Y1: 32MHz; Crystal_SMD_2016-4Pin_2.0x1.6mm; MPN NX2016SA-32M-EXS00A-CS06465; LCSC C1986260

Connections:
+3V3: C6.1, C7.1, C9.1, C10.1, FB1.1, J4.1, R3.1, R4.1, R5.1, R7.1, U3.3 (~CE), U3.6 (VOUT), U4.3 (~CE), U4.6 (VOUT), U5.2 (3V3)
+5V: C1.1, C2.1, D1.1 (K), D2.1 (K), J4.2, U2.1 (VI)
/+3V3_EXT: C5.1, J3.1, U4.1 (VIN)
/+3V3_LDO: C3.1, C4.1, U2.3 (VO), U3.1 (VIN)
/+5V_EXT: D2.2 (A), D3.2 (A2), J2.1
/ANT_HF: C31.1, D7.2 (A2), J6.1 (In), L11.2, L12.1
/ANT_LF: C23.1, C24.2, D6.2 (A2), J5.1 (In), L5.2, L6.1
/BOOT: R5.2, SW2.1, U5.27 (IO0)
/CC1: J1.A5 (CC1), R1.1
/CC2: J1.B5 (CC2), R2.1
/ESP_EN: C8.1, R4.2, SW1.1, U5.3 (EN)
/GPIO1: J4.14, U5.39 (IO1)
/GPIO4: J4.3, U5.4 (IO4)
/GPIO5: J4.4, U5.5 (IO5)
/GPIO6: J4.5, U5.6 (IO6)
/GPIO7: J4.6, U5.7 (IO7)
/GPIO9: J4.7, U5.17 (IO9)
/GPIO38: J4.9, U5.31 (IO38)
/GPIO39: J4.10, U5.32 (IO39)
/GPIO40: J4.11, U5.33 (IO40)
/GPIO41: J4.12, U5.34 (IO41)
/GPIO42: J4.13, U5.35 (IO42)
/GPIO48: J4.8, U5.25 (IO48)
/HF_A: C27.1, L9.2
/HF_B: C27.2, C28.1, C29.1, L10.1
/HF_C: C29.2, C30.1, C32.2, L10.2, L11.1
/HF_RX: C32.1, C33.1, L13.2
/LED_PWR: D4.2 (A), R3.2
/LED_USER: R6.1, U5.38 (IO2)
/LED_USER_A: D5.2 (A), R6.2
/LF_A: C19.1, L3.2
/LF_B: C19.2, C20.1, C21.1, L4.1
/LF_C: C21.2, C22.1, L4.2, L5.1
/LF_RX: C24.1, C25.1, L7.2
/LR_BUSY: U5.23 (IO21), U6.25 (BUSY)
/LR_DIO9: U5.24 (IO47), U6.9 (DIO9)
/LR_MISO: U5.21 (IO13), U6.21 (MISO)
/LR_MOSI: U5.19 (IO11), U6.22 (MOSI)
/LR_NRESET: U5.22 (IO14), U6.20 (NRESET)
/LR_NSS: R7.2, U5.18 (IO10), U6.24 (NSS)
/LR_NTC: R8.2, TH1.1, U6.3 (NTC)
/LR_SCK: U5.20 (IO12), U6.23 (SCK)
/LR_VBAT: C11.1, C12.1, FB1.2, U6.17 (VBAT)
/LR_VNTC: R8.1, U6.6 (VTCXO/VNTC)
/LXA: L1.1, U6.16 (LXA)
/LXB: L1.2, U6.14 (LXB)
/RFI_HF: L13.1, U6.31 (RFI_HF)
/RFI_LF: L7.1, U6.29 (RFI_LF)
/RFO_HF: L8.2, L9.1, U6.32 (RFO_HF)
/RFO_LF: L2.2, L3.1, U6.27 (RFO_LF2), U6.28 (RFO_LF1)
/U0RXD: J4.16, U5.36 (RXD0)
/U0TXD: J4.15, U5.37 (TXD0)
/USB_DN: J1.A7 (D-), J1.B7 (D-), U1.1 (I/O1), U1.6 (I/O1), U5.13 (USB_D-)
/USB_DP: J1.A6 (D+), J1.B6 (D+), U1.3 (I/O2), U1.4 (I/O2), U5.14 (USB_D+)
/VDCC: C14.1, FB2.2, U6.26 (VDCC2)
/VDCC1: C13.1, FB2.1, U6.12 (VDCC1)
/VPAX: C16.1, FB3.2, U6.2 (VPAX2)
/VPAX1: C15.1, FB3.1, U6.13 (VPAX1)
/VR_PA: C17.1, C18.1, C26.1, L2.1, L8.1, U6.1 (VR_PA)
/XTA: U6.4 (XTA), Y1.3
/XTB: U6.5 (XTB), Y1.1
GND: C1.2, C2.2, C3.2, C4.2, C5.2, C6.2, C7.2, C8.2, C9.2, C10.2, C11.2, C12.2, C13.2, C14.2, C15.2, C16.2, C17.2, C18.2, C20.2, C22.2, C23.2, C25.2, C26.2, C28.2, C30.2, C31.2, C33.2, D3.1 (A1), D4.1 (K), D5.1 (K), D6.1 (A1), D7.1 (A1), J1.A1 (GND), J1.A12 (GND), J1.B1 (GND), J1.B12 (GND), J1.S1 (SHIELD), J2.2, J3.2, J4.17, J4.18, J4.19, J4.20, J5.2 (Ext), J6.2 (Ext), L6.2, L12.2, R1.2, R2.2, SW1.2, SW2.2, TH1.2, U1.2 (GND), U2.2 (GND), U3.2 (GND), U4.2 (GND), U5.1 (GND), U5.40 (GND), U5.41 (GND), U6.15 (GND_DCC), U6.30 (GND), U6.33 (GND_EP), Y1.2 (G), Y1.4 (G)
VBUS: D1.2 (A), J1.A4 (VBUS), J1.A9 (VBUS), J1.B4 (VBUS), J1.B9 (VBUS), U1.5 (VBUS)

Notes on the sheet:
POWER INPUT: USB-C 5V / screw-terminal 5V -> Schottky OR -> AP7361C 1A LDO; external 3.3V and LDO 3.3V combined by two LM66100 ideal diodes (highest source wins, reverse-current blocked)
ESP32-S3-WROOM-1U-N16R8, radio unused (native USB on GPIO19/20; GPIO35-37 = PSRAM)
LR2021 core: SIMO DC-DC, 32MHz crystal with NTC compensation (Semtech reference design)
RF: Semtech LR2021 reference design (switchless direct-tie). Top: 868/915MHz (PA_LF up to +22dBm). Bottom: 2.4GHz (PA_HF up to +12dBm). Keep layout tight, 50 ohm GCPW.

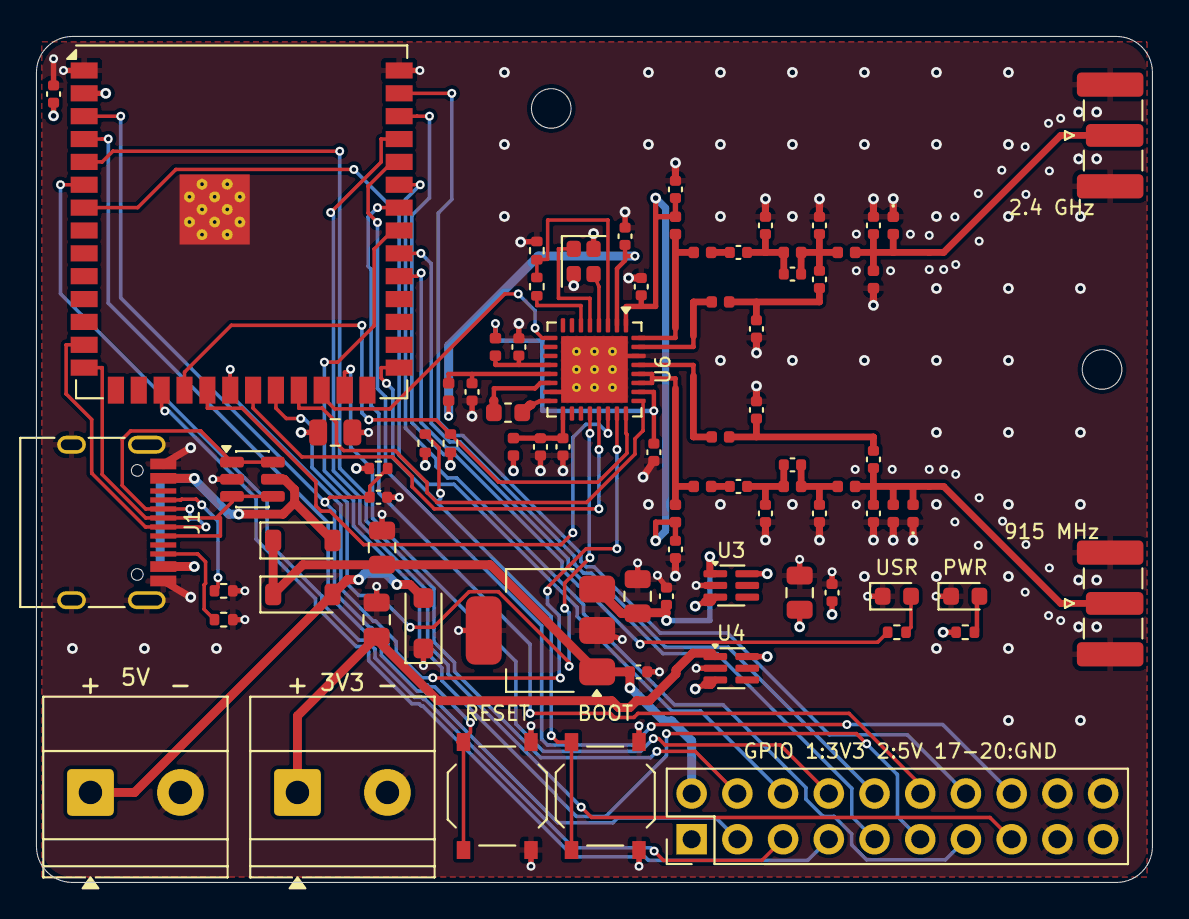
[picture p51: board lr2021_esp32s3.kicad_pcb from above]

Board: 4 copper layers, 62.0 x 47.0 mm, 82 parts (0 on the bottom side), 63 nets.
