ohameiri/maya/(commit log)

2026-10-02 Add LR2021 + ESP32-S3 LoRa board (KiCad 9): schematic, generators, RF layout
    Schematic, project settings and PCB are generated by Python scripts:
    - gen_schematic.py: LR2021 symbol, full schematic (ERC clean apart from the
    intentional LM66100 diode-OR power-out warning)
    - gen_project.py: ERC matrix, net classes (50 ohm RF, power, USB), JLCPCB rules
    - gen_pcb.py: 4-layer placement, hand-routed RF matching (Semtech LR2021
    reference values, 868/915 MHz + 2.4 GHz), SMA feeds, ground pours
    - route.py / export_fab.py: Freerouting stage and fabrication outputs
    Claude-Session: https://claude.ai/code/session_01GybN5CQfdUnddB4A81xgKu
    [lr2021_esp32s3.kicad_pcb, lr2021_esp32s3.kicad_sch]
2026-10-02 Route LR2021 + ESP32-S3 board; add fab outputs and build pipeline
    - In2 becomes a +3V3 plane (L1 sig/RF, L2 GND, L3 3V3, L4 sig); every
    3V3/GND pad gets its own plane via
    - Hand fanout of the LR2021 (crystal, NTC divider, SIMO loop, VBAT/VDCC/
    VPAX, SPI escape vias) and the duplicated USB-C pads; only DIO9 is used
    as IRQ (DIO7/8/11 freed to clear the QFN corner)
    - Freerouting 1.9 routes the rest on L1/L4 (inner layers declared as power
    planes); single-layer vias removed, ~160 GND stitching vias added
    - build.py: project -> schematic -> ERC -> PCB -> route (retried until DRC
    has no unconnected items) -> Gerbers/drill, JLCPCB BOM/CPL, PDFs, previews
    - ERC: 0 errors (1 intentional LM6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
    [lr2021_esp32s3.kicad_pcb, lr2021_esp32s3.kicad_sch, lr2021_esp32s3_bom.csv, lr2021_esp32s3_bom_jlcpcb.csv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]
2026-10-03 Add 3D renders of the LR2021 + ESP32-S3 board
    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
2026-10-03 Add 3D models for the USB-C receptacle and tactile switches
    The KiCad library has no models for the HRO TYPE-C-31-M-12 and XKB TS-1187A
    footprints. gen_3d_models.py builds simplified STEP models (CadQuery) from
    the datasheet dimensions into lib/3d/; gen_pcb.py points the footprints at
    them. 3D renders refreshed.
    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
    [lr2021_esp32s3.kicad_pcb]
2026-10-03 Fix screw terminal orientation: wire entry now faces the board edge
    J2/J3 were placed at 180 deg, which pointed the wire openings into the
    board (confirmed in the 3D view). They are now at 0 deg with the body
    front 0.2 mm inside the edge; +/- silkscreen moved with pin 1 (left pad).
    Board re-routed and re-exported (DRC: 0 errors, 0 unconnected, parity OK).
    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
    [lr2021_esp32s3.kicad_pcb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]
2026-10-03 Fix 3D model hookup and USB-C model front
    - FOOTPRINT.Models() returns a copy, so the local model paths never reached
    the board; gen_pcb.py now rewrites them in the saved file (board patched)
    - USB-C model: the opening cut stopped 0.05 mm short of the front face
    - Orientation checked edge-on: USB-C opening and SMA barrels face out,
    SMA centre pins on the RF pads; renders refreshed
    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
    [lr2021_esp32s3.kicad_pcb]
2026-10-03 Add 3D and drawing gallery for the LR2021 + ESP32-S3 board
    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
2026-10-03 Shrink the board from 90x65 mm to 64x52 mm
    - Re-placed everything around the fixed constraints: ESP32 antenna at the
    top edge, LR2021 RF section and SMAs on the right, USB-C, terminals and
    GPIO header on the left/bottom edges
    - Buttons rotated and moved next to the header; two M3 holes (right edge)
    - GPIO header re-mapped to cut the routes crossing from the module's left
    side: now GPIO4-7, 9, 48, 38-42, 1 + UART, 3V3, 5V, 4x GND
    (GPIO15-18 no longer broken out)
    - route.py keeps a 0.5 mm routing margin along the board edges
    - ERC: 0 errors (intentional LM66100 OR warning); DRC with parity: 0 errors,
    0 unconnected; renders, drawings and fab outputs regenerated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
    [lr2021_esp32s3.kicad_pcb, lr2021_esp32s3.kicad_sch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]
2026-10-03 Switch to ESP32-S3-WROOM-1U-N16R8 and shrink board to 62x47 mm (sources)
    The U.FL module variant has no PCB antenna, so the antenna keepout is gone
    and the module moves inside the board. Adds a STEP model for the module and
    M2 mounting holes. Routed board and fab outputs follow.
    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
    [lr2021_esp32s3.kicad_sch]
2026-10-03 Move H2 out of the header routing channel; hand-route LDO and LED joins
    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
2026-10-03 Route the 62x47 mm WROOM-1U board; regenerate fab outputs and images
    DRC with schematic parity: 0 errors, 0 unconnected, 0 mismatches.
    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
    [lr2021_esp32s3.kicad_pcb, lr2021_esp32s3_bom.csv, lr2021_esp32s3_bom_jlcpcb.csv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]
2026-10-03 Fill in LCSC numbers for every BOM part; switch LEDs to AlInGaP
    Stock checked in JLCPCB's parts search. The LR2021 (C49421489) is listed
    but out of stock, so it needs Global Sourcing or consignment. Blue/InGaN
    LEDs would barely light through 1k on 3.3V; USR is now red.
    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
    [lr2021_esp32s3.kicad_pcb, lr2021_esp32s3.kicad_sch, lr2021_esp32s3_bom.csv, lr2021_esp32s3_bom_jlcpcb.csv]
2026-10-03 README: settings for a fully assembled JLCPCB order
    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
2026-10-03 Pre-production fixes: JLC CPL corrections, LDO decoupling placement
    - export_fab: per-LCSC rotation/offset corrections so JLCPCB places each part
    on our pads (the red LED would have gone in reversed; SOT-23-6, SC-70-6,
    SOT-223 and the SMA were rotated; THT parts and the ESP32/USB-C offset)
    - check_cpl.py: overlays JLCPCB's EasyEDA footprints on our pads
    - U2 rotated so its output cap sits 2.6 mm from OUT (was 9.1 mm); C2 is
    now a 1 uF input cap at IN, as the AP7361C datasheet asks
    - TVS D3 moved next to D2
    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
    [lr2021_esp32s3.kicad_sch]
2026-10-03 Route the reworked power section; pre-production check report
    All eight check groups pass on the final board (see README, Pre-production
    checks). Fab outputs, CPL with JLC corrections and images regenerated.
    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
    [lr2021_esp32s3.kicad_pcb, lr2021_esp32s3_bom.csv, lr2021_esp32s3_bom_jlcpcb.csv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]
2026-10-03 Third round of pre-production checks; add pin-map firmware build
    Gerbers rendered independently of KiCad, firmware compiled against the
    board's pin map, LR2021 SIMO/crystal layout reviewed. All pass. Corrects
    the ESP32 EPAD paste figure (nine windows, 48 %).
    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
    [main.cpp]
2026-10-03 docs: copper layers rendered straight from the Gerbers
    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
2026-10-03 Add two-part 3D-printable enclosure with renders
    Base + lid generated with CadQuery from the board's STEP model: split at the
    SMA axis, M2 screws through the board's mounting holes, openings for USB-C,
    SMA, screw terminals and header, LED holes and flexure RST/BOOT buttons.
    No interference with any component in the 3D model.
    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
    [enclosure_assembly.step, enclosure_base.step, enclosure_base.stl, enclosure_lid.step, enclosure_lid.stl]
2026-10-03 docs: ESP32-S3 module close-up renders
    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
2026-10-04 Design review round 4: antenna ESD diodes and RF via fence
    Full pre-production review with simulations (docs/design_review.md,
    scripts in analysis/):
    - ngspice power-path model: USB plug-in, LoRa TX + Wi-Fi droop,
    inrush and source switchover
    - nodal RF model of both matching networks built from the netlist,
    and a graph comparison against Semtech's e788v01a reference
    - thermal, current capacity and assembly spacing checks
    Fixes:
    - D6/D7 antenna ESD diodes are now fitted (DOWO PESD0402V12,
    C19626255, 0.05 pF, 12 V), as in the reference design
    - add_rf_fence.py adds a 32-via GND fence along both antenna feeds
    after routing; build.py runs it and re-checks DRC
    Fab files regenerated: Ge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
    [lr2021_esp32s3.kicad_pcb, lr2021_esp32s3.kicad_sch, lr2021_esp32s3_bom.csv, lr2021_esp32s3_bom_jlcpcb.csv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]
